anwaypimpalkar/pneumatactors/Content/Pneumatactors_Animation.pptx

Pneumatactors

Pneumatic Solenoids

High

Low

PWM Input

High

Low

Low

1 Atm

Air Pump

1 Atm

Transistor Circuit

High
