anwaypimpalkar/pneumatactors/IEEE Haptics Symposium 2024/Pimpalkar2024_HS2024_WIP.pdf

## Pneumatactor Arrays for High Frequency Vibrotactile Feedback

Anway Pimpalkar¹

, Preshit Ameta²

, Ahan Dalia²

, Jiaxi Zhang²

, and Jeremy D. Brown³

Abstract— Soft and conformable pneumatic tactile interfaces have the potential to complement traditional rigid systems by offering more natural and subtle feedback. This presents the need for economical, scalable miniaturized systems adept in providing high-frequency vibrotactile stimuli. We present the development of a novel silicone-based pneumatic vibrotactor (pneumatactor) array controlled by a sequence of high-frequency air valves engineered to deliver vibrotactile feedback.

I. INTRODUCTION
Traditional vibrotactile haptic displays in common industrial and research applications are built upon largely rigid substrates, and therefore are limited in their abilities to render realistic experiences in a variety of form factors [1]. Pneumatic haptic displays present a promising solution to the limitations of traditional tactile interfaces. Pneumatic bladders, designed to inflate and deflate, can be manufactured in any shape and size, effectively mimicking natural environments. Their adjustable stiffness, which closely resembles human skin, enables the creation of softer, more authentic haptic feedback. Such capabilities hold promise for applications in virtual reality, prosthetics, and beyond. Despite the evident potential, these systems face challenges in bulkiness, cost efficiency, and noise control, which necessitate further development.
High-frequency pneumatic actuation methods have previously been explored. Sonar et al. were pioneers in this field, successfully implementing closed-loop control for solenoidgated pneumatic actuators for frequencies upto 100Hz [2]. Subsequently, van Beek et al. validated the effectiveness of soft Pneumatic Unit Cells [3] with similar frequency characteristics against rigid vibrotactors, utilizing both quantitative and qualitative assessments [4]. However, despite the successful transmission of vibrational data, the resulting devices were notably bulky and costly. In this context, we introduce a novel methodology of producing an arrays of pneumatic vibrotactors (pneumatactors) capable of maintaining frequencies up to 90Hz, while reducing costs by approximately 50% and weight by about 75%.

II. IMPLEMENTATION
The proposed pneumatic tactile haptic device has two intended goals: (1) to rapidly actuate pneumatactors at a range of frequencies controllable through an external trigger,

1Department of Biomedical Engineering, Johns Hopkins University, Baltimore, MD 21218, USA. apimpal1@jhu.edu
2Laboratory for Computational Sensing and Robotics, Johns Hopkins Unjiaiversity, Baltimore, MD 21218, USA. {pameta1, adalia1, jzhan331}@jhu.edu
3Department of Mechanical Engineering, Johns Hopkins University, Baltimore, MD 21218, USA. jdelainebrown@jhu.edu

and (2) to generate independent tactile patterns for the users to feel.
Six cylindrical pneumatactors are fabricated using stereolithography 3D printing with a silicone-based resin. The tactors further undergo a cleaning and curing process for structural hardening. Through an iterative process, the tactors achieve optimized dimensions with an 17mm inner diameter, a 0.4mm diaphragm, a 3mm wall thickness, a 4mm bottom thickness, and a 2mm inlet diameter.
Three sets of pneumatactors are operated by three 3-Way Air Valves. Each valve assembly includes one solenoid connected to a 2.5 l/min 4.5V Air Pump, while the remaining solenoids are interconnected in a parallel arrangement with the first. A unified PWM signal drives three SPDT Relays, which drive the actuation of these valves. At any given instance, airflow within the three valves is directed towards one of the two paired pneumatactors, resulting in a 180◦outof-phase actuation. Since the pump is unidirectionally pumping air out, the valve connection configuration allows the deflation of the other pneumatactor via the third port on the valve, which is open to atmosphere. This deflation is driven by the excess pressure inside the tactor. This setup is depicted in Figure 1 (a) with purple (or labelled ”High”) and green (or labelled ”Low”) arrows highlighting directional flow. The system is controlled by lightweight and stackless multithreads on an Arduino Uno, capable of actuating the three ports with three independent PWM waves.

III. PRELIMINARY ANALYSIS

An inflated pneumatactor is modeled as a spherical cap to estimate the maximum mechanical frequency range possible on the device. The increase in volume V↑ is given by Equation 1:

V↑ =

π × h↑
6

× (3a

2 + h

2
↑
) | (1)

where h↑ is the height of the spherical cap or effective indentation of the skin, and a is the inner radius of the pneumatactor. Using this working volume and the known flow rate, optimization curves are drawn to aid design choices. This method method relies on two key assumptions: 1) the minimum skin indentation sensitivity at higher velocities is approximately 1.5mm for the forearm [5], and 2) the pneumatactor’s maximum deflation time is equal to the inflation time t (constant for given bladder dimensions and material) [6]. Building upon this, Equation 2 determines the pneumatactor’s maximum operational frequency. This corresponds to different skin indent depths at a specified pump flow rate, as depicted in Figure 2.

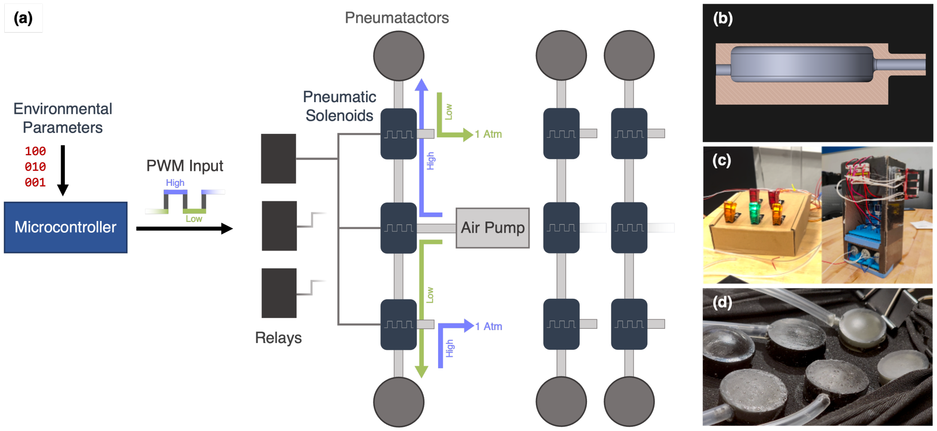
[picture p1: figure]

Fig. 1. (a) Representation of pneumatactor actuation setup, (b) pneumatactor cross-section; (c) constructed actuator prototype; (d) array placement.

fmax =

1
2 ×

V↑
F low Rate

(2)

The device is designed to create skin indentations of 2mm at 90Hz, resulting in an inner radius of 8.5mm based on Equation 2. The indent depth is chosen based on existing literature demonstrating the effectiveness of touch at different levels [5]. These estimated parameters have been validated through the attachment of a piezoelectric disk to the pneumatactor’s diaphragm and high-speed photography.

IV. FUTURE DIRECTIONS

Ongoing efforts are concentrated on quantifying the scalability and resolution of the array. The inverse relationship between frequency and radius in pneumatactors offers exciting prospects for further development. Reducing the size of individual units in an array leads to higher achievable frequencies, although this progression is currently hindered by the actuation speeds of valves and relay circuits. Implementing closed-loop pressure control will allow the pneumatactors to be inflated to a specific pressure and be actuated at specific frequencies centered around it, allowing for both mechanotactile and vibrotactile feedback at the same site. Further reduction in hardware size is also crucial for creating compact, portable systems. Additionally, future perceptual studies with the pneumatactors and comparing the outcomes to those from rigid vibrotactile displays will offer significant insights into the effectiveness of the device.

ACKNOWLEDGMENT

The authors extend their thanks to Shaopeng “Jaspor” Jiang and Dr. Axel Krieger from the IMERSE Lab at Johns Hopkins University for their pivotal role in the manufacturing process of the pneumatactors.

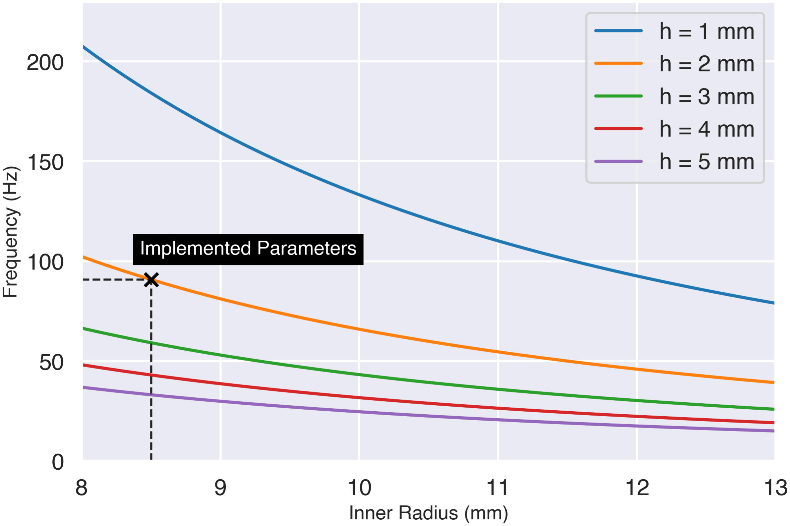
[picture p2: figure]

Fig. 2. Frequency-inner radius relationship and the chosen parameters.

REFERENCES

[1] A. A. Stanley and A. M. Okamura, “Controllable Surface Haptics via Particle Jamming and Pneumatics,” IEEE Transactions on Haptics, vol. 8, no. 1. Institute of Electrical and Electronics Engineers (IEEE), pp. 20–30, Jan. 01, 2015.
[2] H. A. Sonar, A. P. Gerratt, S. P. Lacour, and J. Paik, “Closed-Loop Haptic Feedback Control Using a Self-Sensing Soft Pneumatic Actuator Skin,” Soft Robotics, vol. 7, no. 1. Mary Ann Liebert Inc, pp. 22–29, Feb. 01, 2020.
[3] K. D. Kommuri, F. E. Van Beek, and I. A. Kuling, “Fabrication and Characterization of Pneumatic Unit Cell Actuators,” Actuators, vol. 13, no. 2. MDPI AG, p. 45, Jan. 23, 2024.
[4] F. E. van Beek, Q. P. I. Bisschop, and I. A. Kuling, “Validation of a soft Pneumatic Unit Cell (PUC) in a VR experience: a comparison between vibrotactile and soft pneumatic haptic feedback,” IEEE Transactions on Haptics. Institute of Electrical and Electronics Engineers (IEEE), pp. 1–11, 2024.
[5] P. Burgess, J. Mei, R. Tuckett, K. Horch, C. Ballinger, and D. Poulos, “The neural signal for skin indentation depth. I. Changing indentations,” The Journal of Neuroscience, vol. 3, no. 8. Society for Neuroscience, pp. 1572–1585, Aug. 01, 1983.
[6] H. Bakeri et al., “Silicone Elastomeric-Based Materials of Soft Pneumatic Actuator for Lower-Limb Rehabilitation: Finite Element Modelling and Prototype Experimental Validation,” Applied Sciences, vol. 13, no. 5. MDPI AG, p. 2977, Feb. 25, 2023.
