anwaypimpalkar/pneumatactors/CAD/Tube/Array Idea.png

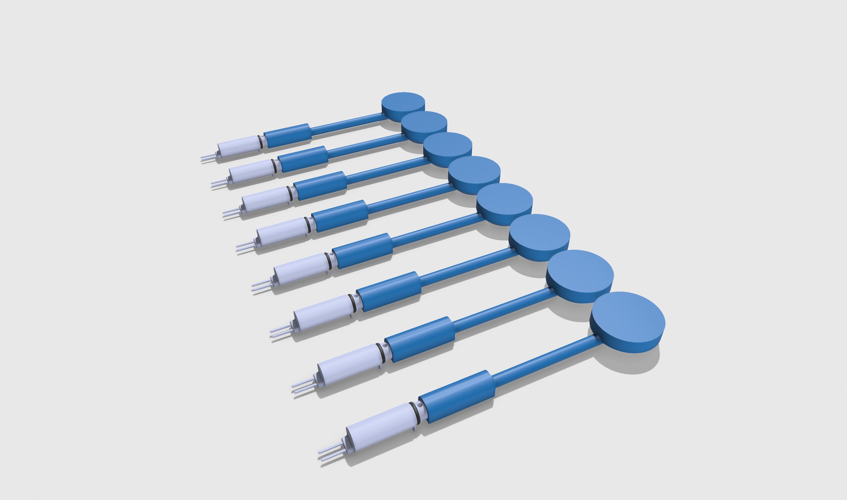
CAD/Tube/Array Idea.png
