anwaypimpalkar/pneumatactors/PCBs/Pneumatactors_1Xiao_CompactControl_Battery/Pneumatactors_1Xiao_CompactControl_Battery_Back.png

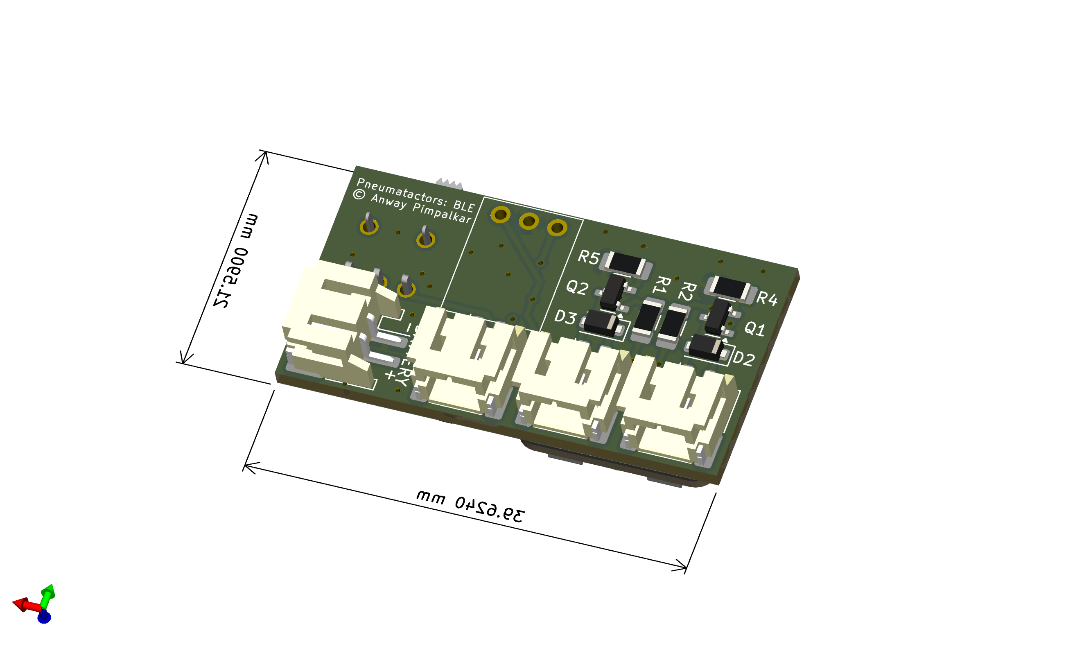
PCBs/Pneumatactors_1Xiao_CompactControl_Battery/Pneumatactors_1Xiao_CompactControl_Battery_Back.png
