anwaypimpalkar/pneumatactors/PCBs/Pneumatactors_1Xiao_CompactControl_Battery/Pneumatactors_1Xiao_CompactControl_Battery_Front.png

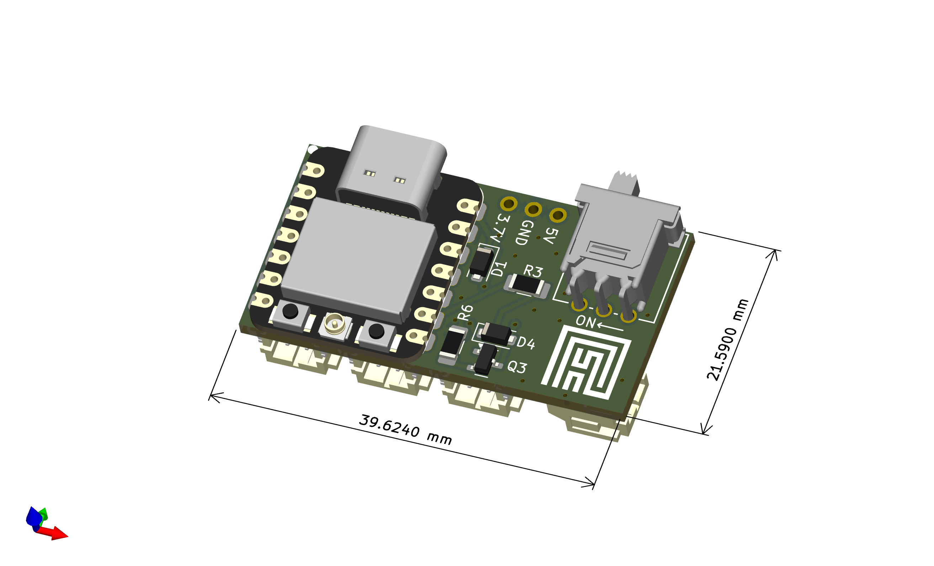
PCBs/Pneumatactors_1Xiao_CompactControl_Battery/Pneumatactors_1Xiao_CompactControl_Battery_Front.png
