anwaypimpalkar/pneumatactors/Hannah's Files/pneucuff_files/pneucuff_33mm_valveandportintegration_latticeonly.SLDASM

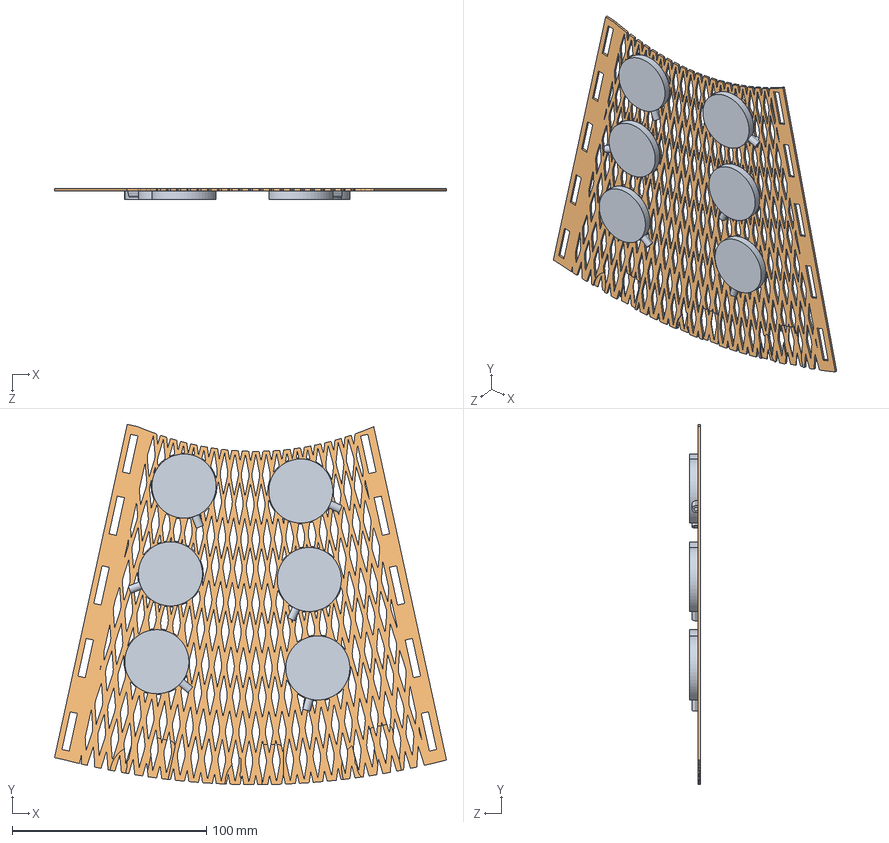
[picture p7: CAD file, 2025-06-20]
Hannah's Files/pneucuff_files/pneucuff_33mm_valveandportintegration_latticeonly.SLDASM
201.7 x 185.3 x 5.44 mm
flex_cuff_v4_square
pneu_33mm_multiconfigport x 6
