anwaypimpalkar/pneumatactors/3D Printing/Anway (Don't Delete Please)- I WILL DO IT/Pneumatactors_Wrist_Pad.3mf

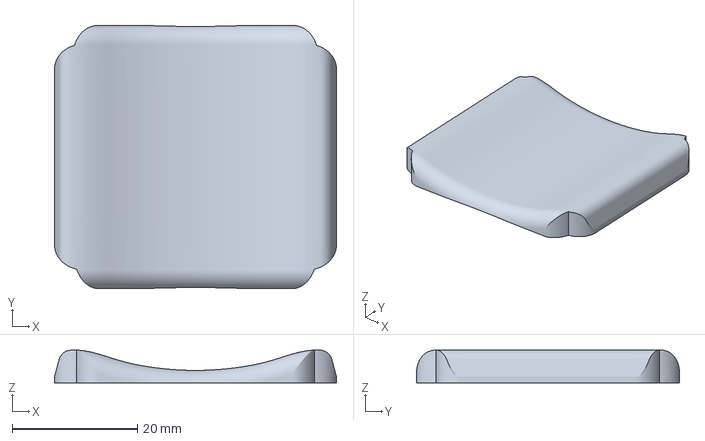
[picture p8: CAD file, 2025-06-20]
3D Printing/Anway (Don't Delete Please)- I WILL DO IT/Pneumatactors_Wrist_Pad.3mf
45.0 x 42.0 x 5.25 mm
