anwaypimpalkar/pneumatactors/CAD/Finger/Final Set/FingerCup_SingleChambers_v4_10Set_ForPrinting/FingerCup_SingleChambers_v4_10Set_ForPrinting_24mm.step

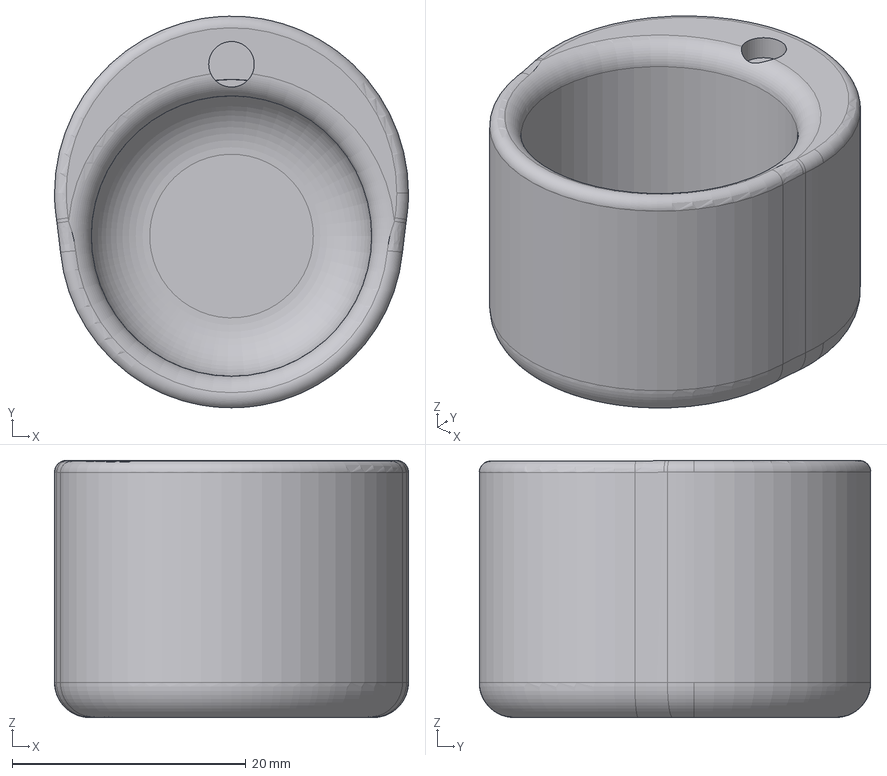
[picture p9: CAD file, 2025-06-20]
CAD/Finger/Final Set/FingerCup_SingleChambers_v4_10Set_ForPrinting/FingerCup_SingleChambers_v4_10Set_ForPrinting_24mm.step
30.3 x 33.5 x 22.0 mm
