anwaypimpalkar/pneumatactors/CAD/Finger/Finger_SingleChamber_v3_15.6.step

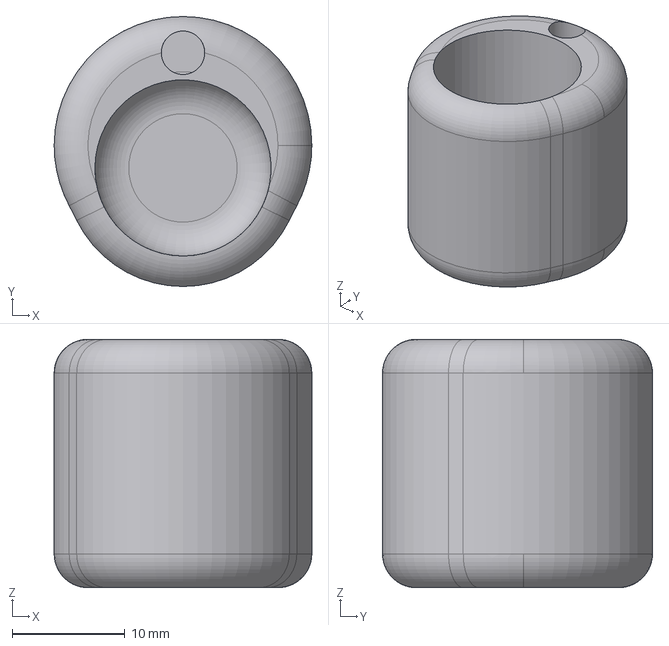
[picture p10: CAD file, 2025-06-20]
CAD/Finger/Finger_SingleChamber_v3_15.6.step
22.8 x 23.9 x 22.0 mm
