anwaypimpalkar/pneumatactors/CAD/HAND/Pneumatactor_HAND_v3_15.6.stl

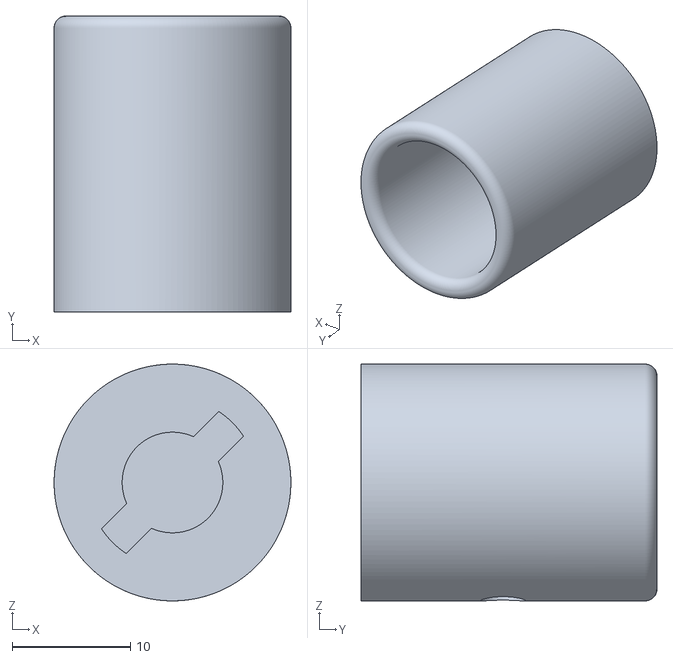
[picture p11: CAD file, 2025-03-19]
CAD/HAND/Pneumatactor_HAND_v3_15.6.stl
20.0 x 25.0 x 20.0
