anwaypimpalkar/pneumatactors/CAD/PUC_WIP_7_23mm.STL

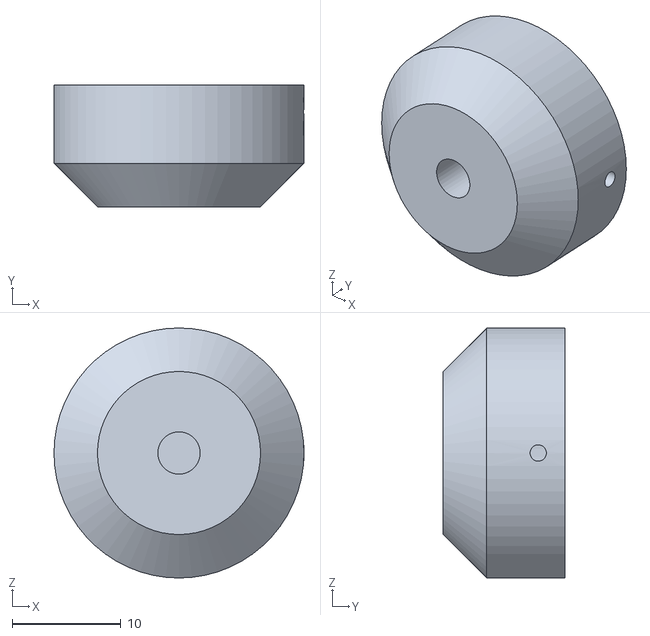
[picture p12: CAD file, 2025-03-06]
CAD/PUC_WIP_7_23mm.STL
23.0 x 11.2 x 23.0
