anwaypimpalkar/pneumatactors/CAD/Test Box/Pneumtactors_TestBed_Box.obj

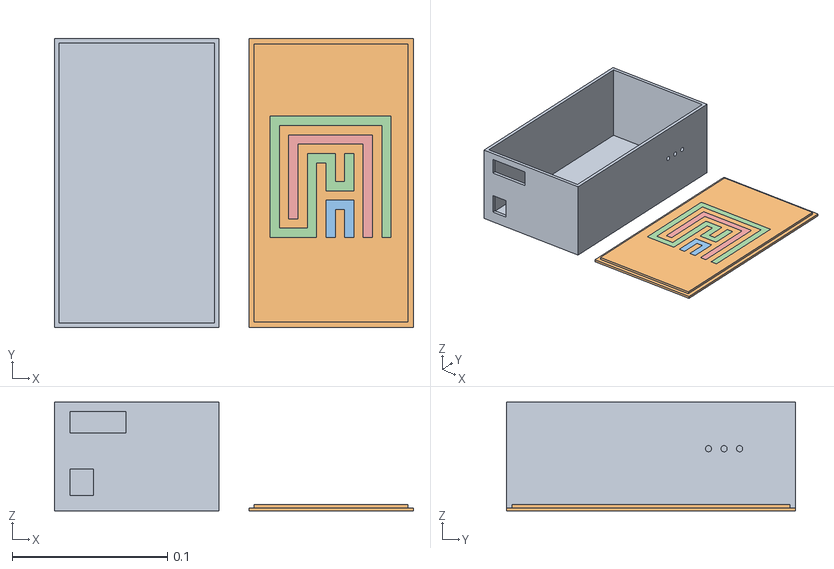
[picture p13: CAD file, 2025-06-20]
CAD/Test Box/Pneumtactors_TestBed_Box.obj
0.231 x 0.186 x 0.07
