anwaypimpalkar/pneumatactors/CAD/Tube/Pneumatactor_Tube_Extension.step

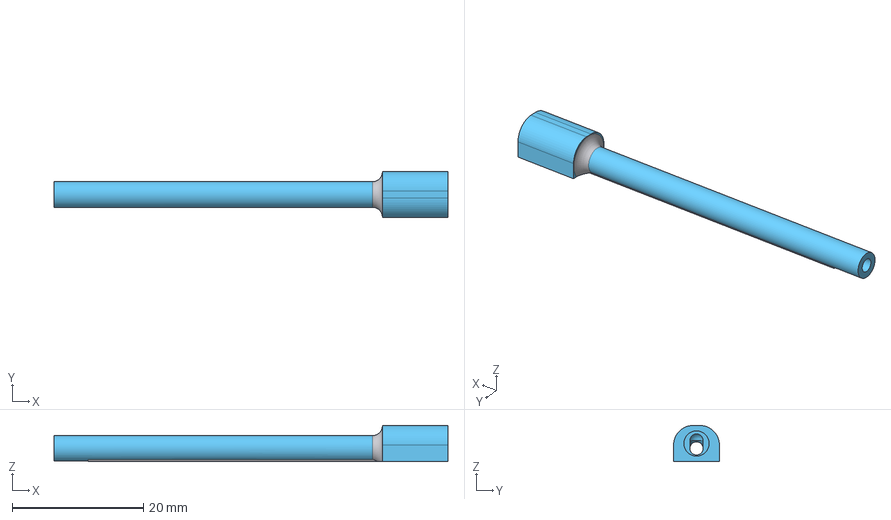
[picture p14: CAD file, 2025-06-20]
CAD/Tube/Pneumatactor_Tube_Extension.step
60.0 x 7.00 x 5.50 mm
PUC_WIP_FDM.STEP x 2
Imported
