anwaypimpalkar/pneumatactors/CAD/Valve Holder/Solenoid Holder with tubing.SLDPRT

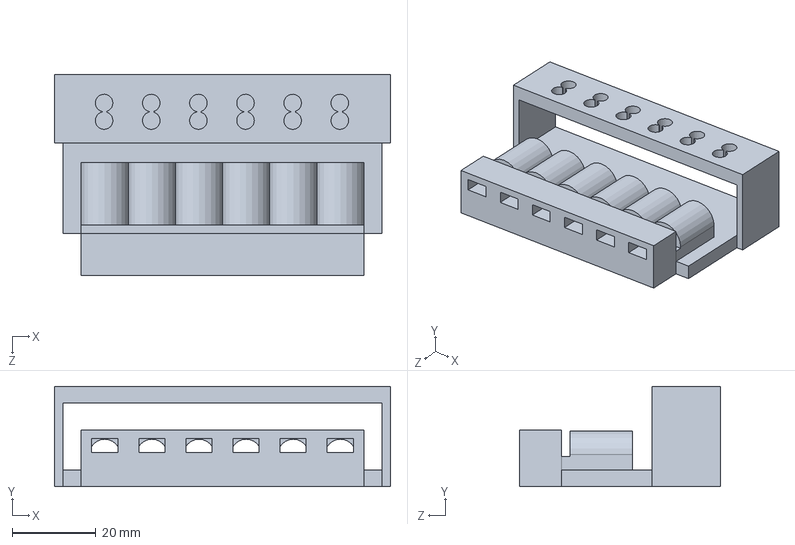
[picture p15: CAD file, 2025-03-29]
CAD/Valve Holder/Solenoid Holder with tubing.SLDPRT
80.3 x 24.0 x 48.0 mm
