anwaypimpalkar/pneumatactors/CAD/Valves/Lee-LHQ_Series-3-Port_Plug-In-CAD_Model_A2.step

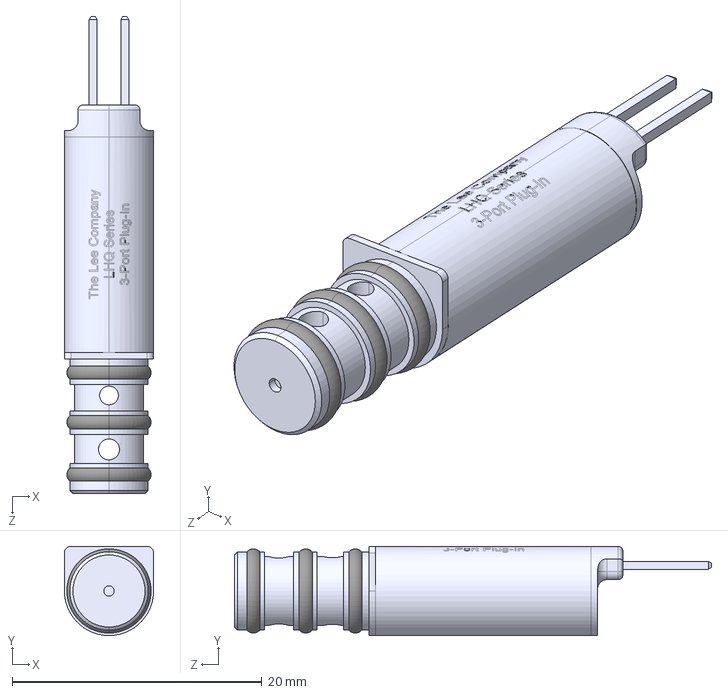
[picture p16: CAD file, 2025-06-20]
CAD/Valves/Lee-LHQ_Series-3-Port_Plug-In-CAD_Model_A2.step
7.14 x 7.14 x 38.2 mm
