anwaypimpalkar/pneumatactors/CAD/VR Task/upper_pointer_finger_v2.STEP

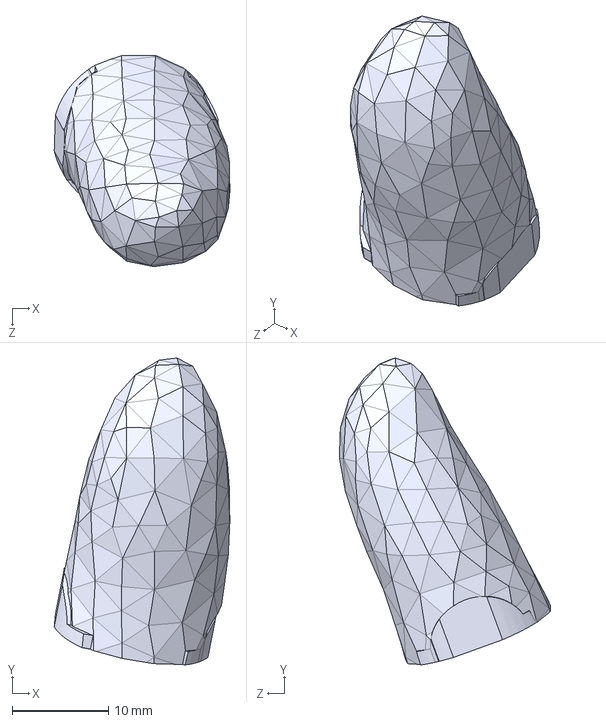
[picture p17: CAD file, 2025-06-20]
CAD/VR Task/upper_pointer_finger_v2.STEP
18.3 x 31.9 x 22.0 mm
