anwaypimpalkar/pneumatactors/CAD/Wrist/Pneumatactors_WristSqueeze.stl

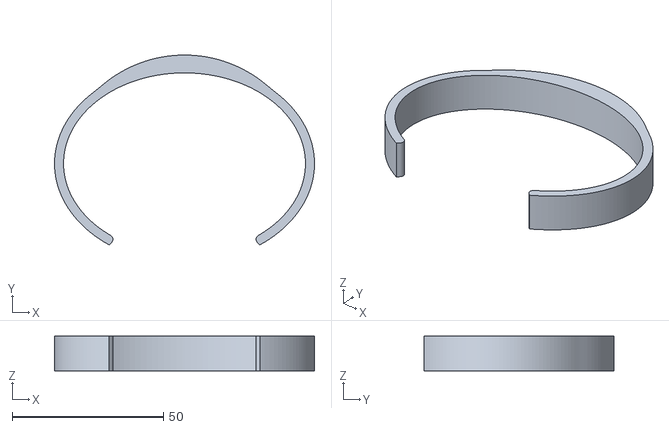
[picture p18: CAD file, 2025-06-20]
CAD/Wrist/Pneumatactors_WristSqueeze.stl
86.0 x 62.8 x 11.5
