anwaypimpalkar/pneumatactors/Hannah's Files/Hannah's Files Cleaned/handdevice_tubeprint_v2_female.STEP

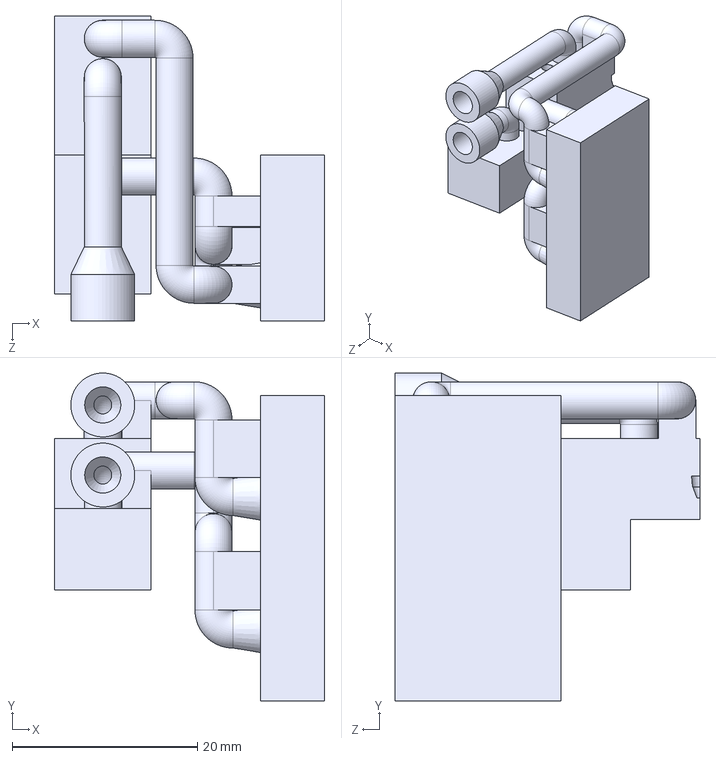
[picture p19: CAD file, 2025-06-20]
Hannah's Files/Hannah's Files Cleaned/handdevice_tubeprint_v2_female.STEP
29.2 x 35.4 x 32.9 mm
