anwaypimpalkar/pneumatactors/Hannah's Files/pneucuff_files/handdevice_tubeprint_v1.STEP

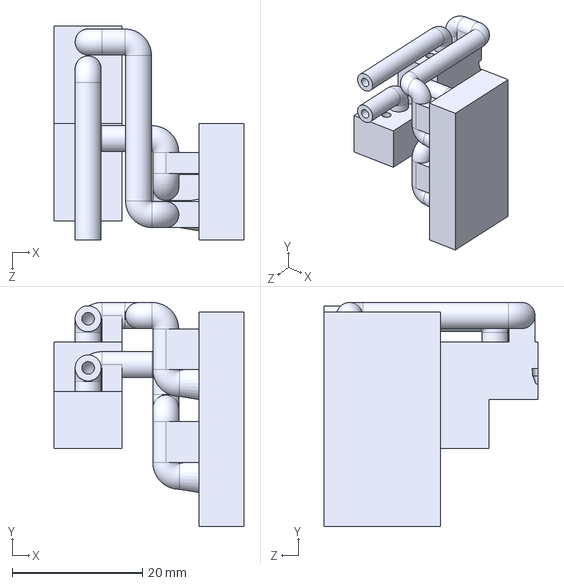
[picture p20: CAD file, 2025-06-20]
Hannah's Files/pneucuff_files/handdevice_tubeprint_v1.STEP
29.2 x 34.5 x 32.9 mm
