anwaypimpalkar/pneumatactors/PCBs/Pneumatactors_1Xiao_3Pumps_8Valves/Pneumatactors_1Xiao_3Pumps_8Valves.step

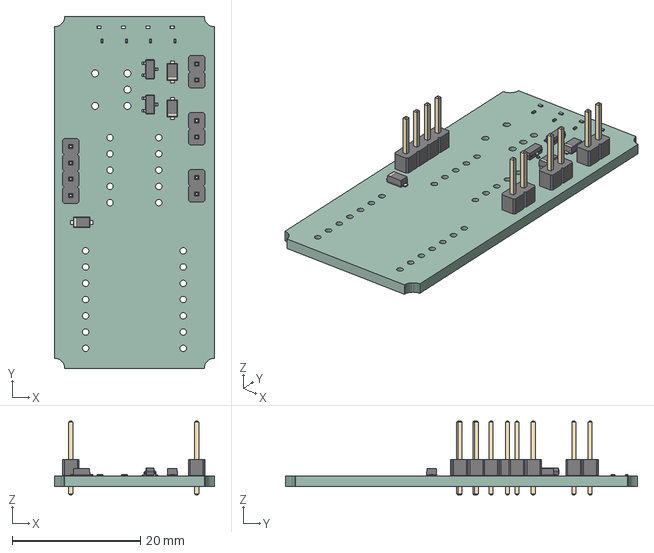
[picture p24: CAD file, 2025-03-29]
PCBs/Pneumatactors_1Xiao_3Pumps_8Valves/Pneumatactors_1Xiao_3Pumps_8Valves.step
25.0 x 55.0 x 11.5 mm
Pneumatactors_1Xiao_CompactControl PCB
