anwaypimpalkar/pneumatactors/PCBs/Pneumatactors_1Xiao_PiezoPumps_2Valves/Pneumatactors_ Pneumatactors_1Xiao_PiezoPumps_2Valves.step

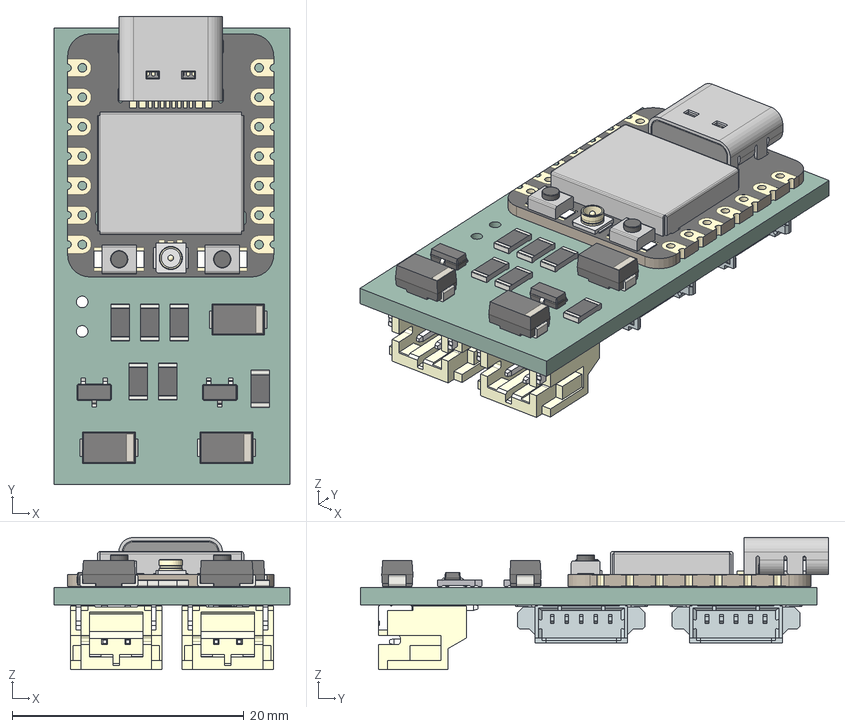
[picture p25: CAD file, 2025-06-20]
PCBs/Pneumatactors_1Xiao_PiezoPumps_2Valves/Pneumatactors_ Pneumatactors_1Xiao_PiezoPumps_2Valves.step
20.3 x 40.4 x 11.4 mm
R_1206_3216Metric x 6
D_SMA x 3
SOT-23 x 2
BOSS-EXTRUDE14_8_
BOSS-EXTRUDE7_4_
BOSS-EXTRUDE7_3_
BOSS-EXTRUDE14_4_
BOSS-EXTRUDE14_2_
BOSS-EXTRUDE14_11_
BOSS-EXTRUDE7_7_
BOSS-EXTRUDE14_9_
BOSS-EXTRUDE14_3_
BOSS-EXTRUDE14_7_
MIRROR2
BOSS-EXTRUDE14_5_
BOSS-EXTRUDE14_12_
BOSS-EXTRUDE7_8_
BOSS-EXTRUDE7_1_
BOSS-EXTRUDE14_10_
BOSS-EXTRUDE7_9_
BOSS-EXTRUDE14_6_
BOSS-EXTRUDE14_1_
BOSS-EXTRUDE7_6_
BOSS-EXTRUDE7_2_
CUT-EXTRUDE5
BOSS-EXTRUDE7_5_
U.FL Connector v1
Button (1) x 2
Shield
PinHeader_1x02_P2.54mm_Vertical
S2B-PH-SM4-TB x 2
Pneumatactors_1Xiao_PiezoPumps_2Valves_Wrong_PCB
