anwaypimpalkar/pneumatactors/PCBs/Pneumatactors_EmbeddedPressureSensing/2450AT18B100E/2450AT18B100E.step

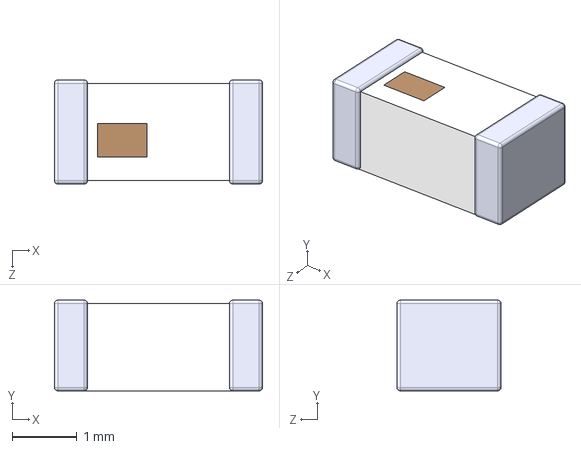
[picture p26: CAD file, 2025-06-20]
PCBs/Pneumatactors_EmbeddedPressureSensing/2450AT18B100E/2450AT18B100E.step
3.20 x 1.40 x 1.60 mm
