anwaypimpalkar/pneumatactors/PCBs/Pneumatactors_EmbeddedPressureSensing/BHSD_1225_SM/BHSD-1225-SM.step

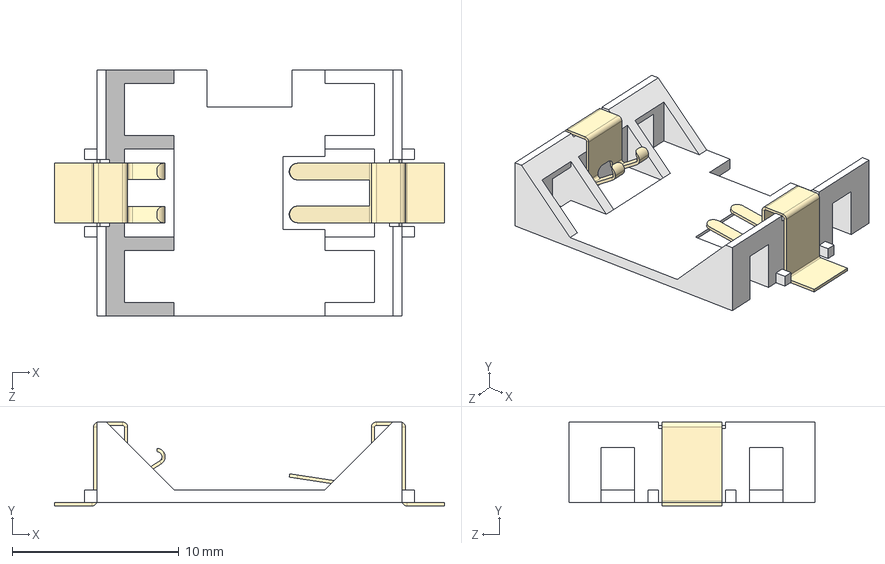
[picture p27: CAD file, 2025-06-20]
PCBs/Pneumatactors_EmbeddedPressureSensing/BHSD_1225_SM/BHSD-1225-SM.step
23.4 x 5.03 x 14.7 mm
