anwaypimpalkar/pneumatactors/PCBs/Pneumatactors_EmbeddedPressureSensing/ESP32_S3/ESP32-S3.step

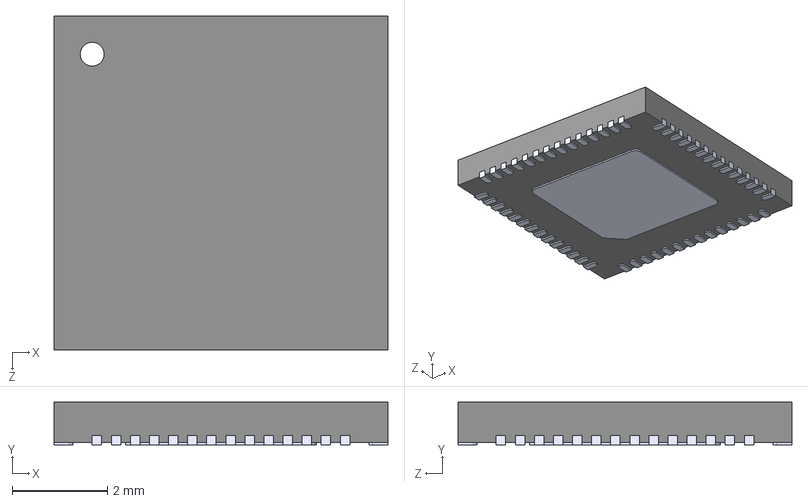
[picture p28: CAD file, 2025-06-20]
PCBs/Pneumatactors_EmbeddedPressureSensing/ESP32_S3/ESP32-S3.step
7.00 x 0.9 x 7.00 mm
