anwaypimpalkar/pneumatactors/CAD/Finger/Final Set/FingerCup_SingleChambers_v4_10Set_ForPrinting/FingerCup_SingleChambers_v4_10Set_ForPrinting_17mm.step

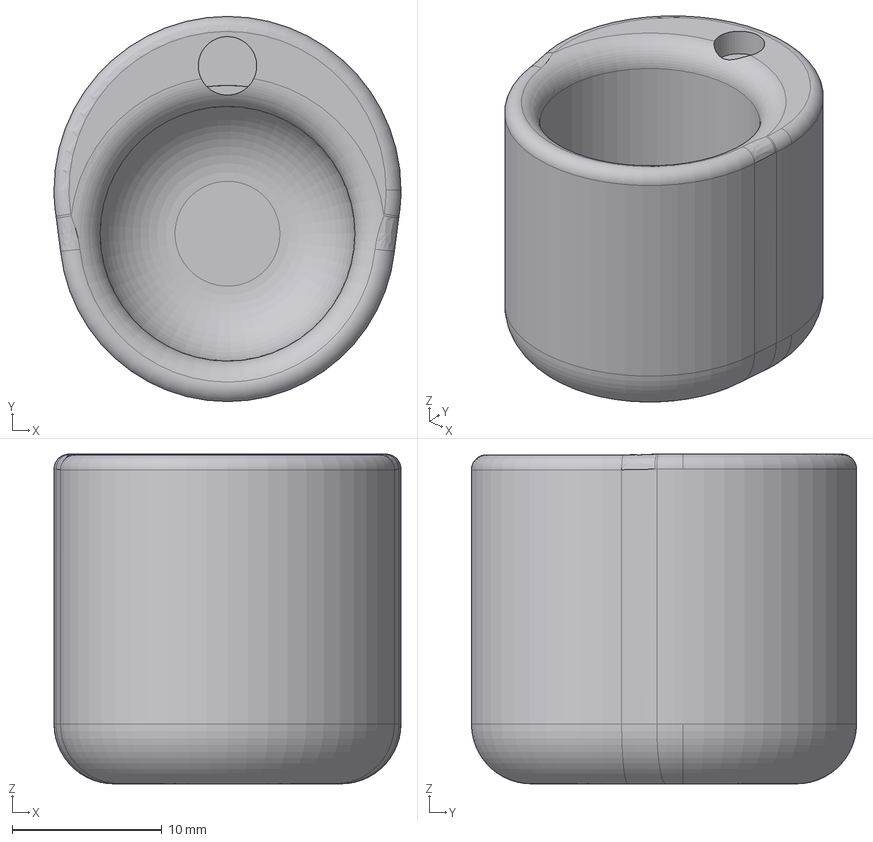
[picture p29: CAD file, 2025-06-20]
CAD/Finger/Final Set/FingerCup_SingleChambers_v4_10Set_ForPrinting/FingerCup_SingleChambers_v4_10Set_ForPrinting_17mm.step
23.2 x 25.7 x 22.0 mm
