anwaypimpalkar/pneumatactors/CAD/Test Box/Pneumatactors_Testbed_STEP.step

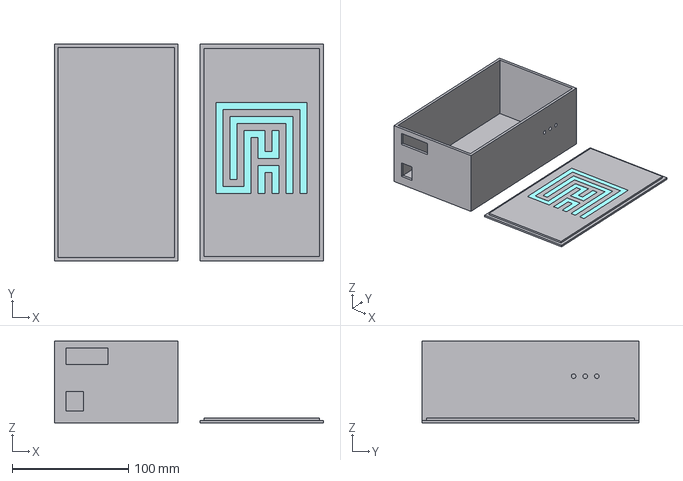
[picture p30: CAD file, 2025-06-20]
CAD/Test Box/Pneumatactors_Testbed_STEP.step
231.0 x 186.0 x 70.0 mm
