anwaypimpalkar/pneumatactors/Hannah's Files/pneucuff_files/pneu_23mm_femalesideconnect.STEP

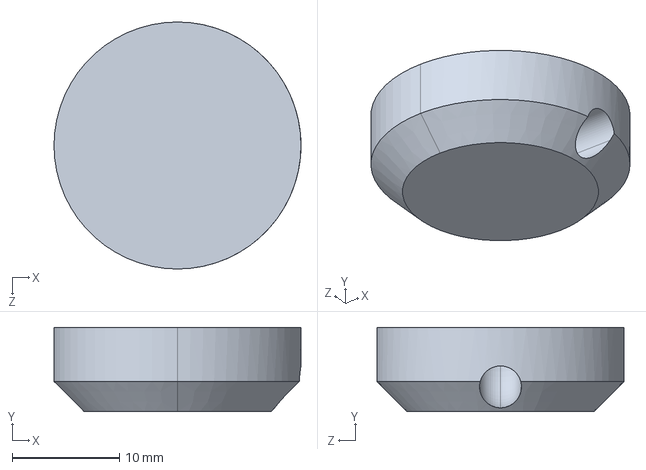
[picture p31: CAD file, 2025-06-20]
Hannah's Files/pneucuff_files/pneu_23mm_femalesideconnect.STEP
23.0 x 7.84 x 23.0 mm
