anwaypimpalkar/pneumatactors/CAD/Finger/Final Set/FingerCup_SingleChambers_v4_10Set_ForPrinting/FingerCup_SingleChambers_v4_10Set_ForPrinting_22mm.step

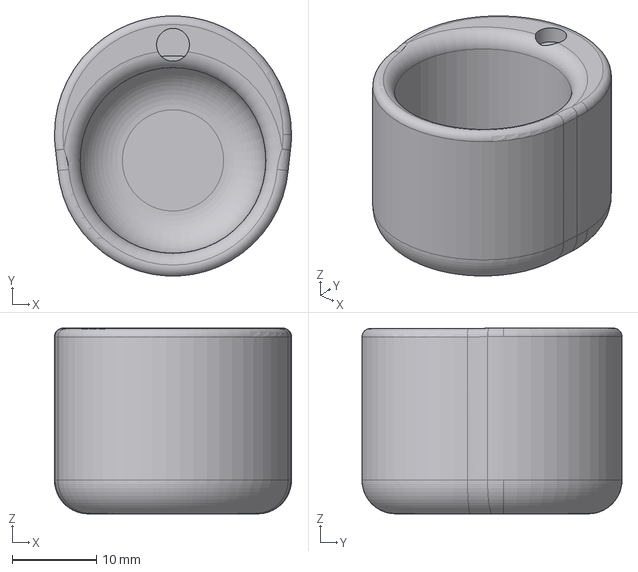
[picture p32: CAD file, 2025-06-20]
CAD/Finger/Final Set/FingerCup_SingleChambers_v4_10Set_ForPrinting/FingerCup_SingleChambers_v4_10Set_ForPrinting_22mm.step
28.1 x 30.8 x 22.0 mm
