anwaypimpalkar/pneumatactors/Hannah's Files/Hannah's Files Cleaned/flex_cuff_v4_square.SLDPRT

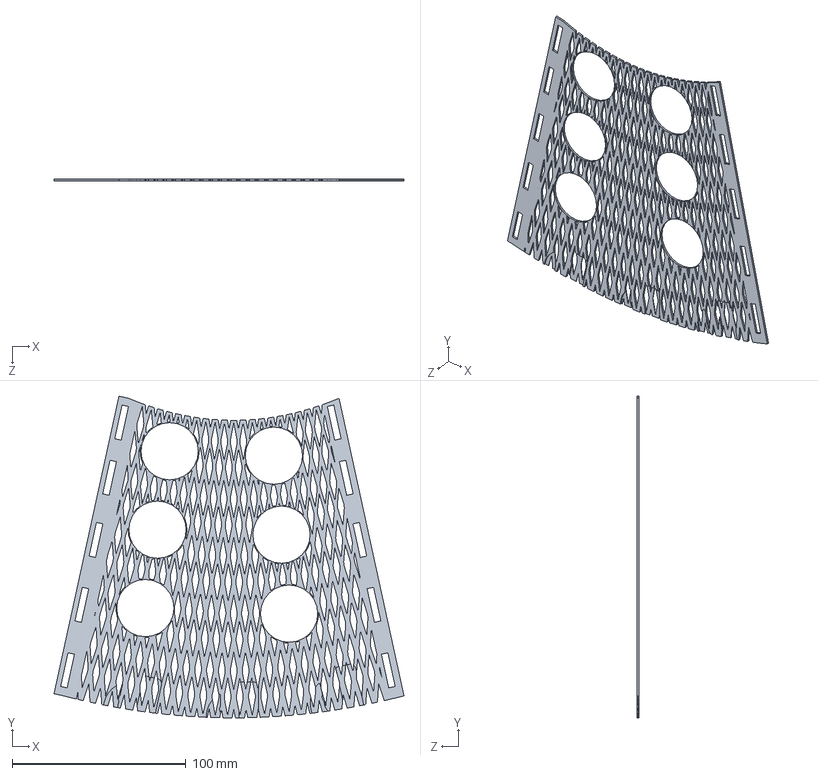
[picture p33: CAD file, 2025-06-20]
Hannah's Files/Hannah's Files Cleaned/flex_cuff_v4_square.SLDPRT
201.7 x 185.3 x 1.27 mm
