anwaypimpalkar/pneumatactors/CAD/Finger/Final Set/FingerCup_SingleChambers_v4_10Set_ForPrinting/FingerCup_SingleChambers_v4_10Set_ForPrinting_18mm.step

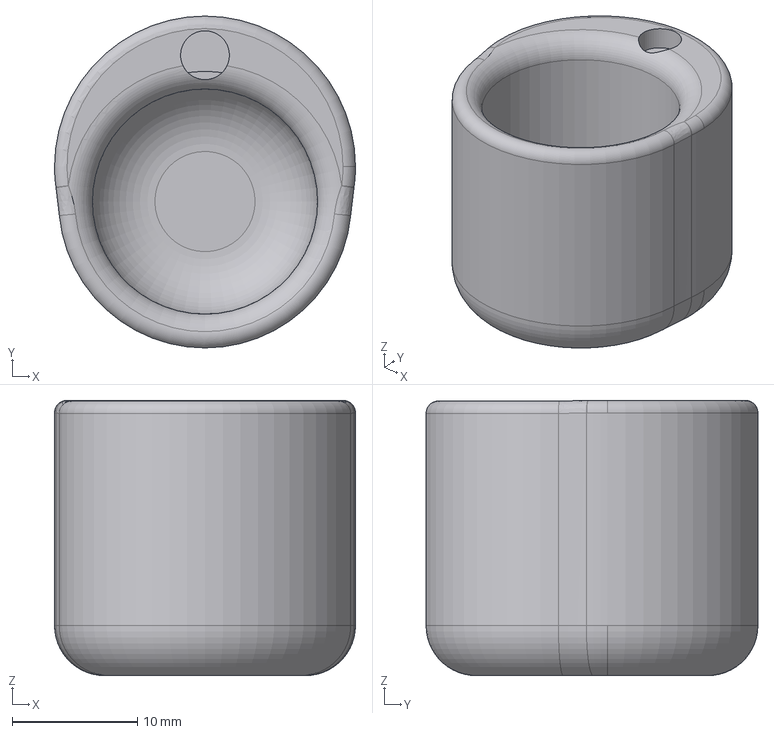
[picture p34: CAD file, 2025-06-20]
CAD/Finger/Final Set/FingerCup_SingleChambers_v4_10Set_ForPrinting/FingerCup_SingleChambers_v4_10Set_ForPrinting_18mm.step
24.1 x 26.5 x 22.0 mm
