anwaypimpalkar/pneumatactors/CAD/Finger/Finger_SingleChamber_v2_15.6.stl

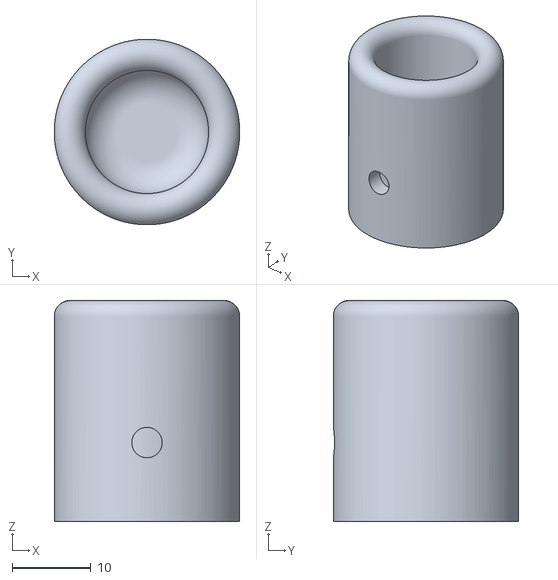
[picture p35: CAD file, 2025-03-06]
CAD/Finger/Finger_SingleChamber_v2_15.6.stl
23.5 x 23.5 x 28.0
