anwaypimpalkar/pneumatactors/Hannah's Files/Hannah's Files Cleaned/pneucuff_23mm_femaletopconnect_wstraps.SLDPRT

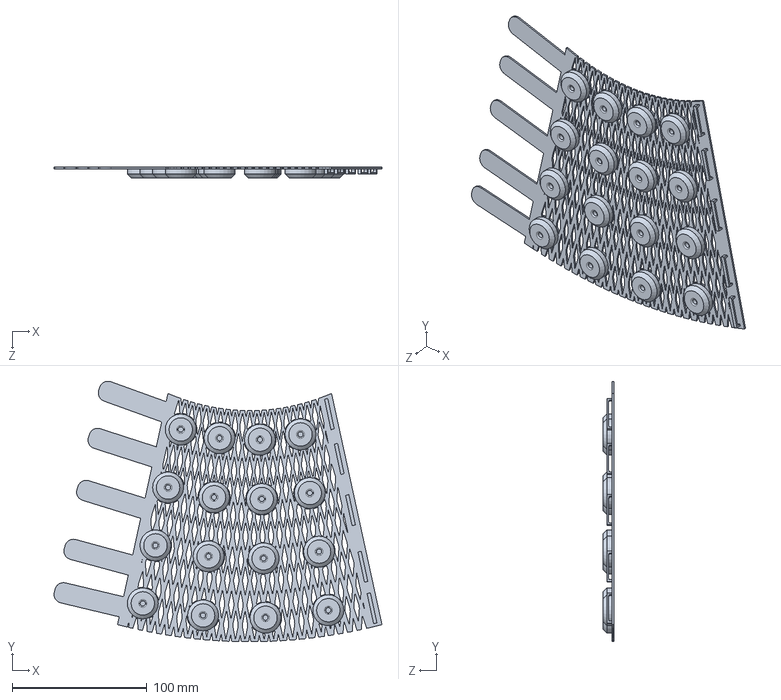
[picture p36: CAD file, 2025-06-20]
Hannah's Files/Hannah's Files Cleaned/pneucuff_23mm_femaletopconnect_wstraps.SLDPRT
243.3 x 193.2 x 7.84 mm
