anwaypimpalkar/pneumatactors/CAD/Finger/Final Set/FingerCup_SingleChambers_v4_10Set_ForPrinting/FingerCup_SingleChambers_v4_10Set_ForPrinting_21mm.step

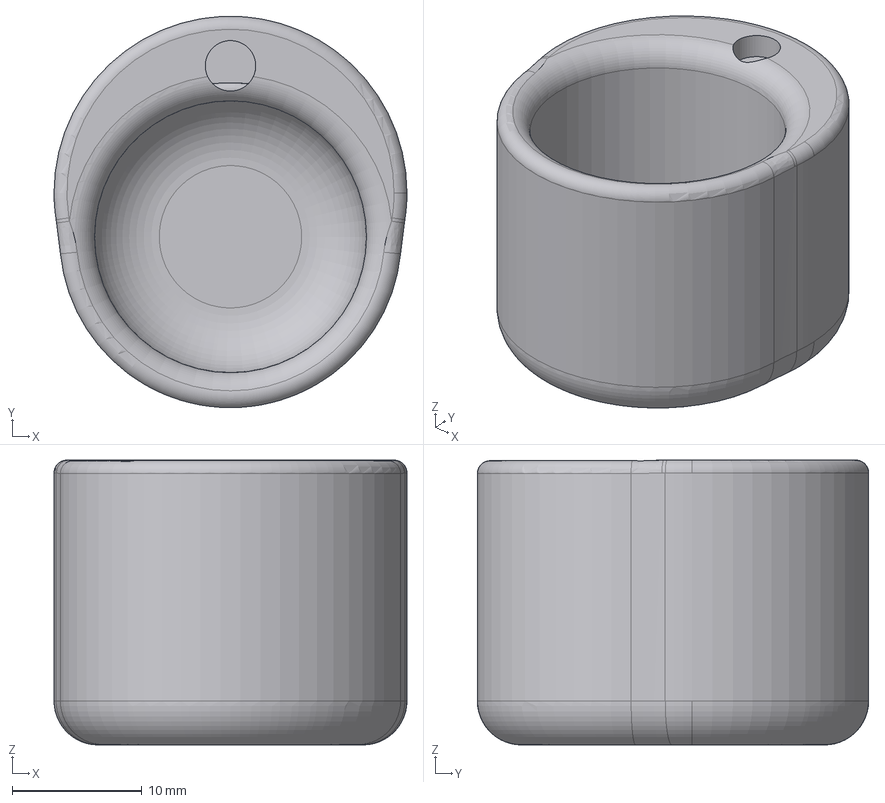
[picture p37: CAD file, 2025-06-20]
CAD/Finger/Final Set/FingerCup_SingleChambers_v4_10Set_ForPrinting/FingerCup_SingleChambers_v4_10Set_ForPrinting_21mm.step
27.3 x 30.2 x 22.0 mm
