anwaypimpalkar/pneumatactors/Hannah's Files/Hannah's Files Cleaned/pneucuff_33mm_withfemaletubing.SLDPRT

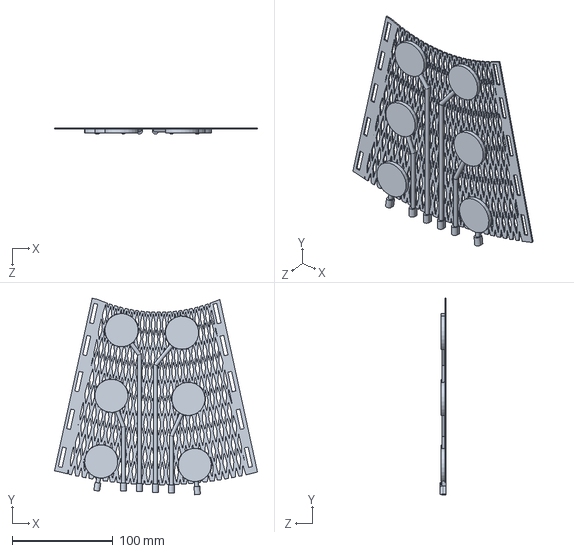
[picture p38: CAD file, 2025-06-20]
Hannah's Files/Hannah's Files Cleaned/pneucuff_33mm_withfemaletubing.SLDPRT
201.7 x 195.3 x 6.12 mm
