anwaypimpalkar/pneumatactors/Hannah's Files/pneucuff_files/Y coupler.SLDPRT

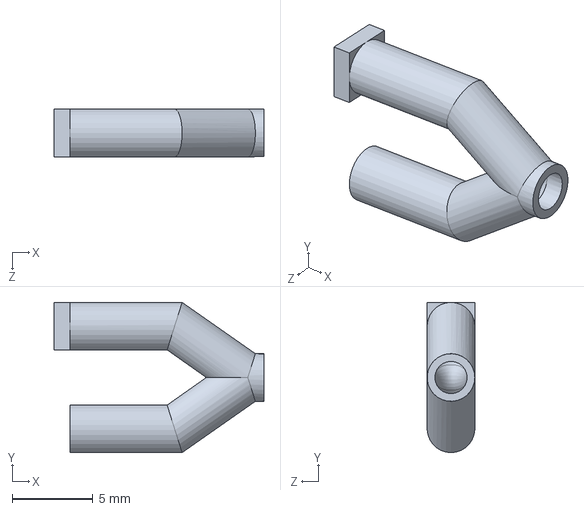
[picture p39: CAD file, 2025-06-20]
Hannah's Files/pneucuff_files/Y coupler.SLDPRT
13.0 x 9.30 x 2.95 mm
