anwaypimpalkar/pneumatactors/Hannah's Files/Hannah's Files Cleaned/pneucuff_23mm_holes_nostraps.SLDPRT

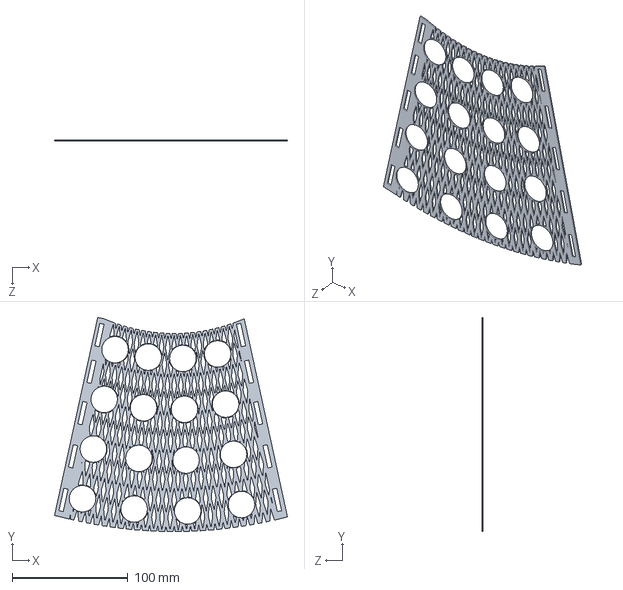
[picture p41: CAD file, 2025-06-20]
Hannah's Files/Hannah's Files Cleaned/pneucuff_23mm_holes_nostraps.SLDPRT
201.7 x 185.3 x 1.27 mm
