anwaypimpalkar/pneumatactors/Hannah's Files/Hannah's Files Cleaned/pneu_33mm_multiconfigport.SLDPRT

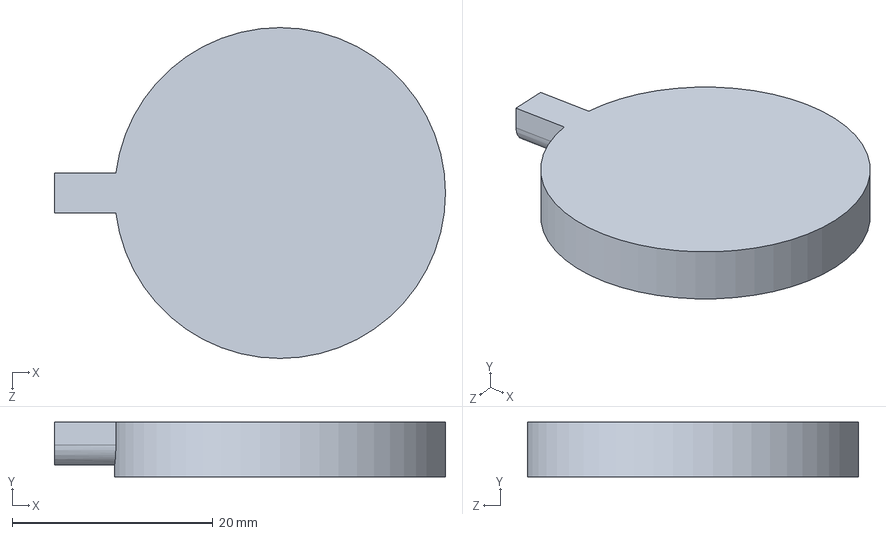
[picture p43: CAD file, 2025-06-20]
Hannah's Files/Hannah's Files Cleaned/pneu_33mm_multiconfigport.SLDPRT
39.0 x 5.44 x 33.0 mm
