anwaypimpalkar/pneumatactors/Hannah's Files/Hannah's Files Cleaned/pneutubing_femaleadapter.SLDPRT

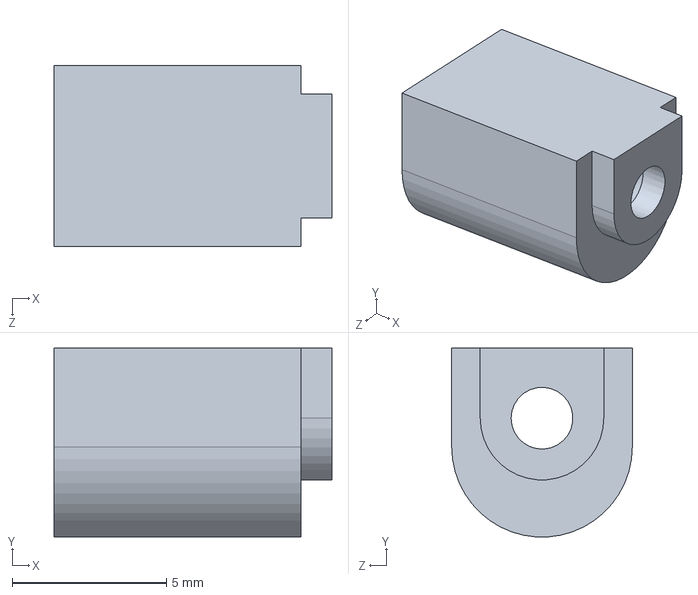
[picture p45: CAD file, 2025-06-20]
Hannah's Files/Hannah's Files Cleaned/pneutubing_femaleadapter.SLDPRT
9.00 x 6.11 x 5.85 mm
