anwaypimpalkar/pneumatactors/Hannah's Files/Hannah's Files Cleaned/ported_valve.SLDPRT

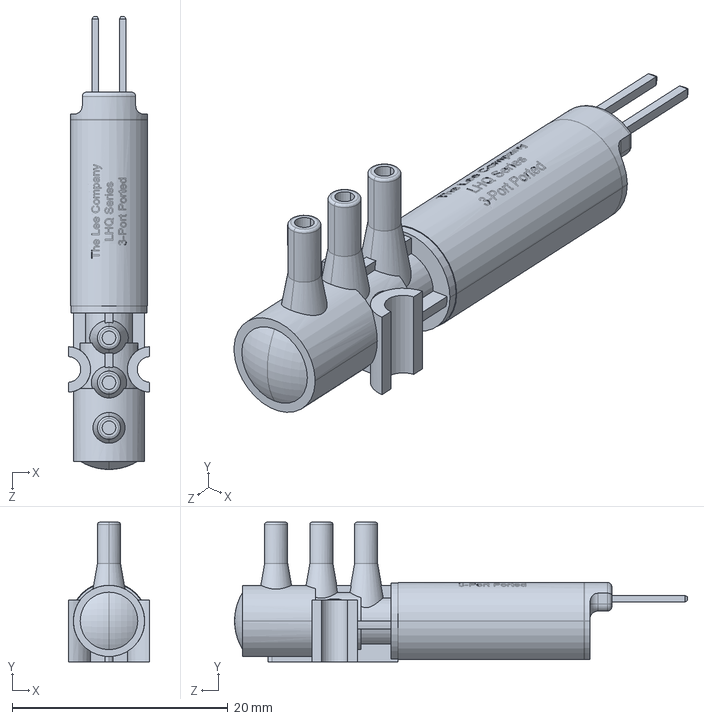
[picture p48: CAD file, 2025-06-20]
Hannah's Files/Hannah's Files Cleaned/ported_valve.SLDPRT
7.47 x 12.9 x 42.0 mm
