anwaypimpalkar/pneumatactors/Hannah's Files/Hannah's Files Cleaned/pneucuff_23mm_femalesideconnect_nostraps.SLDASM

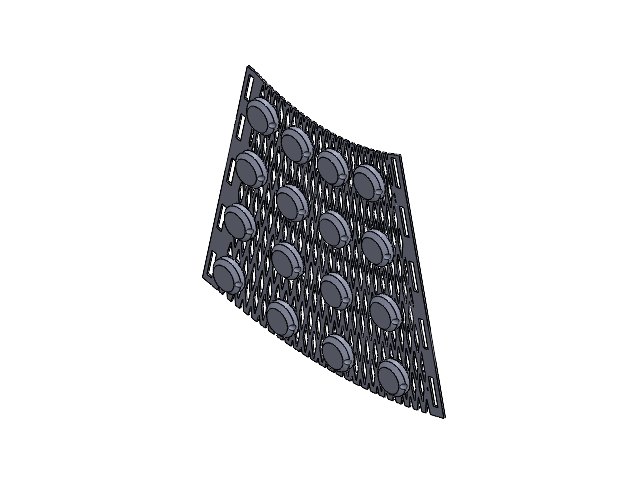
[picture p49: CAD file, 2025-06-20]
Hannah's Files/Hannah's Files Cleaned/pneucuff_23mm_femalesideconnect_nostraps.SLDASM
pneucuff_23mm_holes_nostraps
pneu_23mm_femalesideconnect x 16
