anwaypimpalkar/pneumatactors/Hannah's Files/Hannah's Files Cleaned/dualvalvehousingv2_valveandportasm.SLDASM

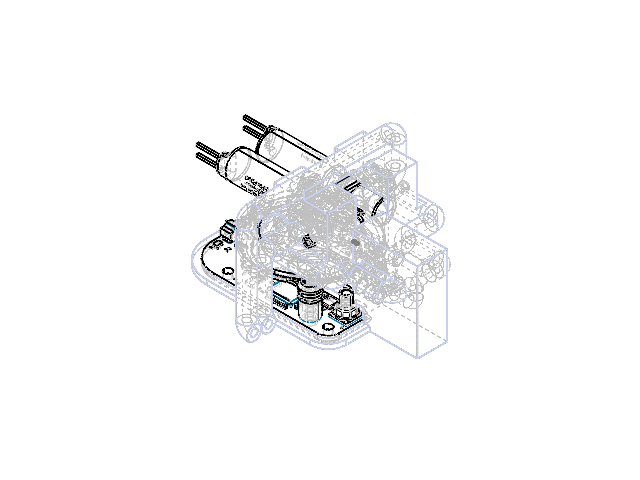
[picture p50: CAD file, 2025-06-20]
Hannah's Files/Hannah's Files Cleaned/dualvalvehousingv2_valveandportasm.SLDASM
pump_pcb
dualvalvehousingv2_ported_pneucuffintegration
ported_valve x 2
