anwaypimpalkar/pneumatactors/Hannah's Files/pneucuff_files/pump_pcb.SLDASM

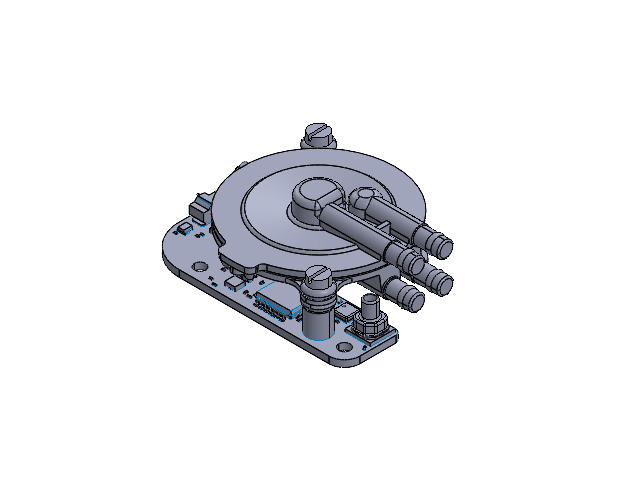
[picture p51: CAD file, 2025-06-20]
Hannah's Files/pneucuff_files/pump_pcb.SLDASM
59017-900-0453.step
ttp-ventus-disc-pump-bl-xp-lt-series-model.step
59017-900-0450 sub part flexi tail.step
59017-900-0450-sub-part-rigidiser.step
EK-02-0035.step x 4
EK-02-0034.step x 2
