anwaypimpalkar/pneumatactors/(list of files, cad)

Other CAD files:
CAD/Tube/Pneumatactor_Tube.stl
CAD/Test Box/Pneumatactors Test Box.stl
Hannah's Files/pneucuff_files/pneucuff_33mm_withfemaletubing_duplicate.SLDPRT
Hannah's Files/Hannah's Files Cleaned/pneucuff_33mm_withfemaletubing_duplicate.SLDPRT
CAD/Finger/Finger_SingleChamber_v1.stl
CAD/Finger/Finger_SingleChamber_v2_15.2.stl
CAD/HAND/Pneumatactor_HAND_v1.stl
CAD/HAND/Pneumatactor_HAND_v2.stl
CAD/Pump/dd2102200_asm.stp
CAD/Valve Holder/Solenoid Holder with tubing.STL
Hannah's Files/Hannah's Files Cleaned/pneu_23mm_femalesideconnect.SLDPRT
Hannah's Files/Hannah's Files Cleaned/portless_valve.SLDPRT
Hannah's Files/pneucuff_files/pneu_23mm_femalesideconnect.SLDPRT
Hannah's Files/pneucuff_files/portless_valve.SLDPRT
PCBs/Components/PicoBlade 2 Pin Vertical/533984002.stp
PCBs/Components/PicoBlade 5 Pin/0532610571.stp
PCBs/Components/Picoblade 8 Pin/532610871.stp
PCBs/Pneumatactors_EmbeddedPressureSensing/MS580301BA01_00/MS580301BA01-00.STEP
