anwaypimpalkar/pneumatactors/Virtual Task/p02/p02_calibration_raw.csv

Timestamp (s) | Raw EMG | Filtered EMG
0.0 | -0.776519775390625 | 0.5552455455293608
0.0004980564117431641 | -0.76080322265625 | 0.5569061146534777
0.0009958744049072266 | -0.76080322265625 | 0.5585615519224114
0.0014908313751220703 | -0.76080322265625 | 0.560211904897597
0.001987934112548828 | -0.76080322265625 | 0.5618572204097012
0.002482175827026367 | -0.31646728515625 | 0.5620766001278235
0.002978801727294922 | -0.31646728515625 | 0.562295890858082
0.0034744739532470703 | -0.31646728515625 | 0.5625150927092957
0.0044672489166259766 | -0.31646728515625 | 0.5627342057900614
0.004961967468261719 | 0.038909912109375 | 0.5626949513205334
0.0054607391357421875 | 0.038909912109375 | 0.5626556941059561
0.0059566497802734375 | 0.038909912109375 | 0.5626164341457518
0.0069468021392822266 | 0.400848388671875 | 0.563116870405715
0.009922027587890625 | 0.400848388671875 | 0.5636168229930563
0.010417938232421875 | 0.714874267578125 | 0.5652931399407334
0.010915040969848633 | 0.714874267578125 | 0.5669642894489932
0.01141047477722168 | 0.714874267578125 | 0.5686303192337376
0.012403726577758789 | -0.079193115234375 | 0.5686332313731453
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
