anwaypimpalkar/pneumatactors/Virtual Task/p01/p01_calibration_raw.csv

Timestamp (s) | Raw EMG | Filtered EMG
0.0 | -0.066375732421875 | 0.0501125790304989
0.0004956722259521484 | -0.068817138671875 | 0.050582930433198614
0.0009894371032714844 | -0.068817138671875 | 0.051048946800198544
0.0014853477478027344 | -0.068817138671875 | 0.05151074586957316
0.001981496810913086 | -0.08056640625 | 0.052149145134267494
0.002477407455444336 | -0.08056640625 | 0.05277926106864143
0.003468751907348633 | -0.08056640625 | 0.05340142569004268
0.0039653778076171875 | -0.08453369140625 | 0.05408484882839751
0.004461050033569336 | -0.08453369140625 | 0.05475887083525851
0.004956960678100586 | -0.08453369140625 | 0.05542389654131085
0.0054531097412109375 | -0.08453369140625 | 0.05607634476471782
0.005949497222900391 | -0.08453369140625 | 0.05672078430808865
0.00842905044555664 | -0.0787353515625 | 0.057269280918808306
0.008928298950195312 | -0.07080078125 | 0.05770554354535352
0.009424209594726562 | -0.07080078125 | 0.05813852453056741
0.009920120239257812 | -0.07080078125 | 0.058568297007519976
0.01041555404663086 | -0.0677490234375 | 0.05895983016347974
0.010909557342529297 | -0.0677490234375 | 0.05934875468706889
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
