anwaypimpalkar/pneumatactors/TLC Valves/EFS LHDA Specs from Handbook.pdf

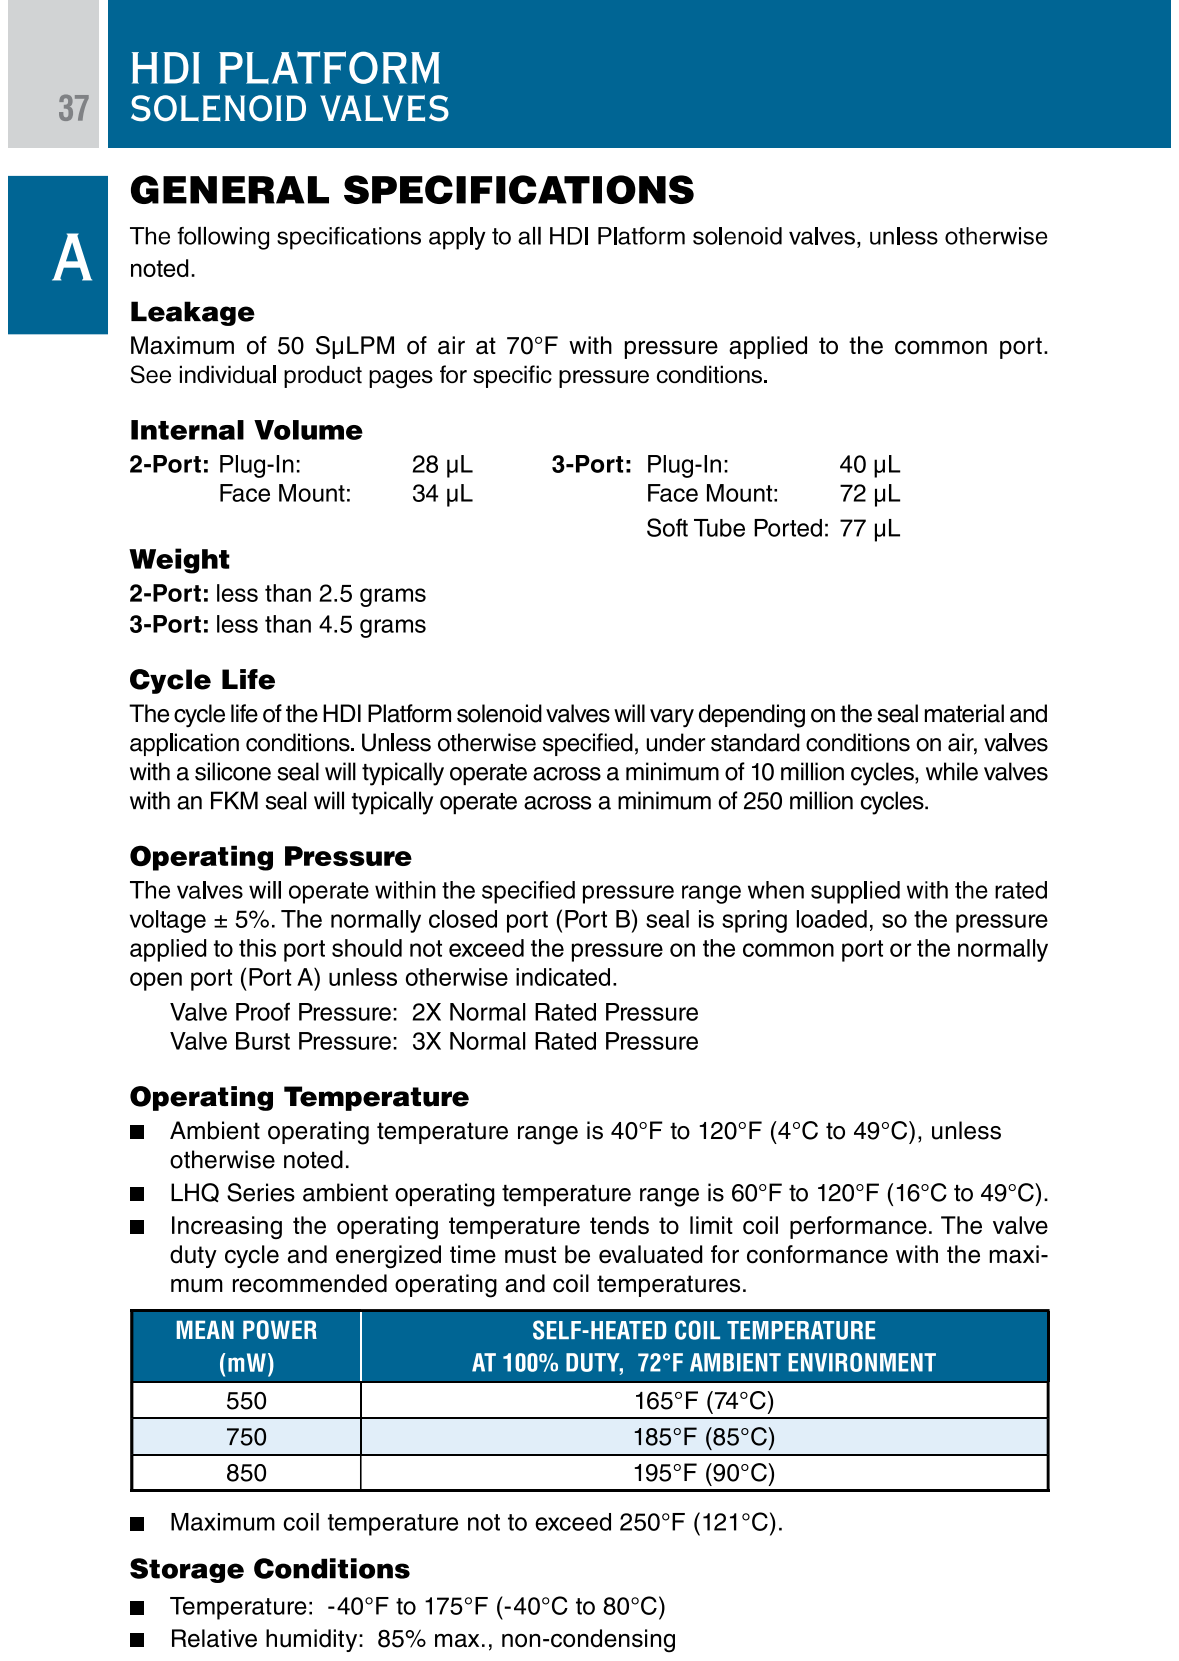
[picture p52: page 1]

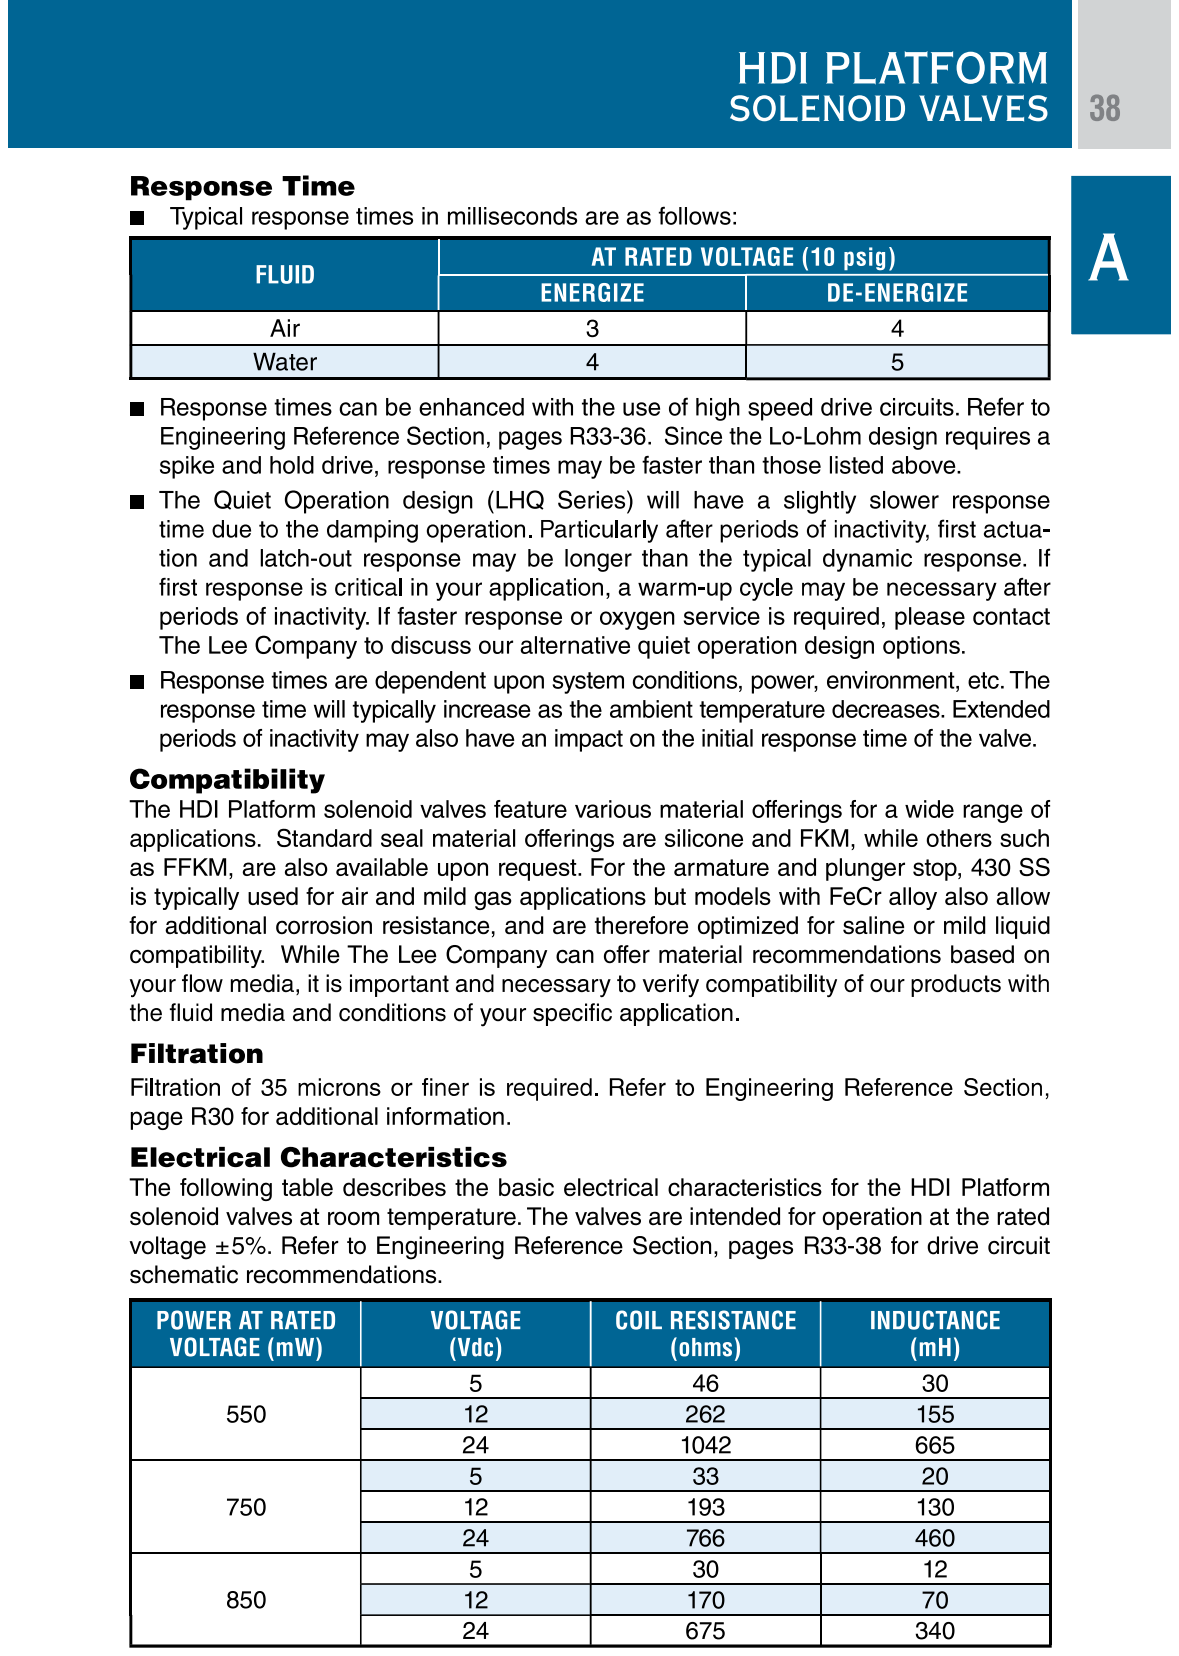
[picture p53: page 2]

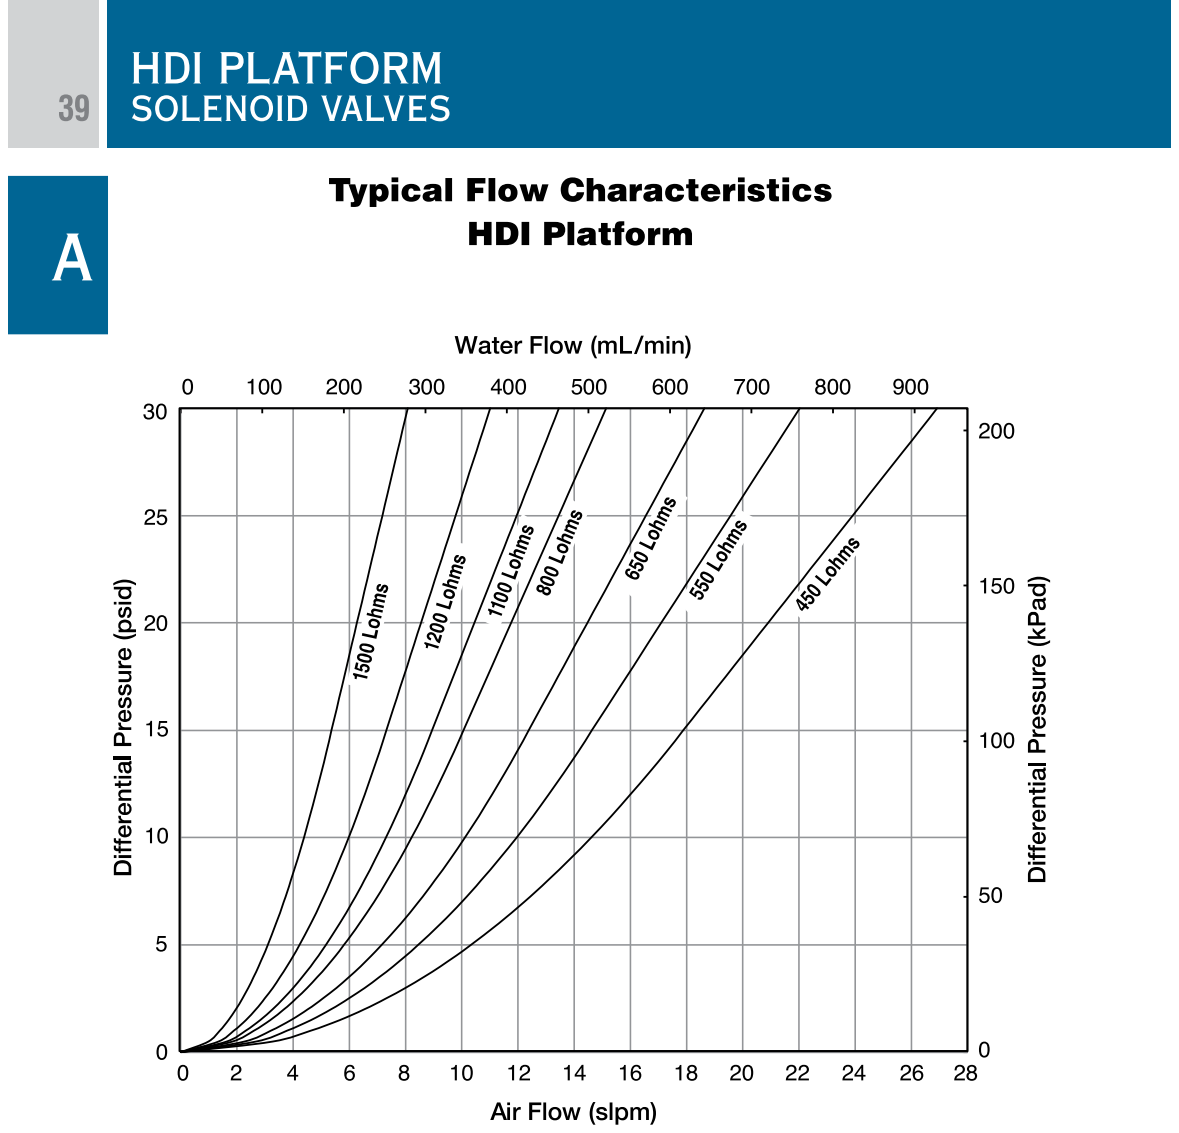
[picture p54: page 3]

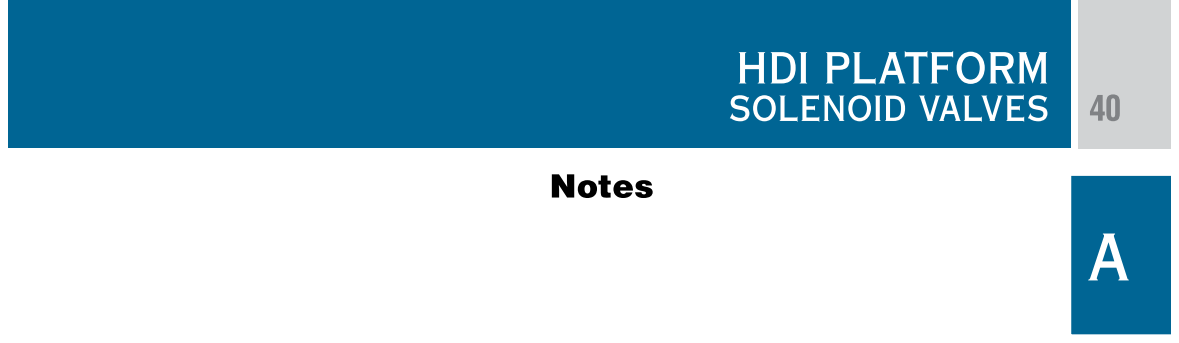
[picture p55: page 4]
