anwaypimpalkar/pneumatactors/TLC Valves/HDI Conventional Models.pdf

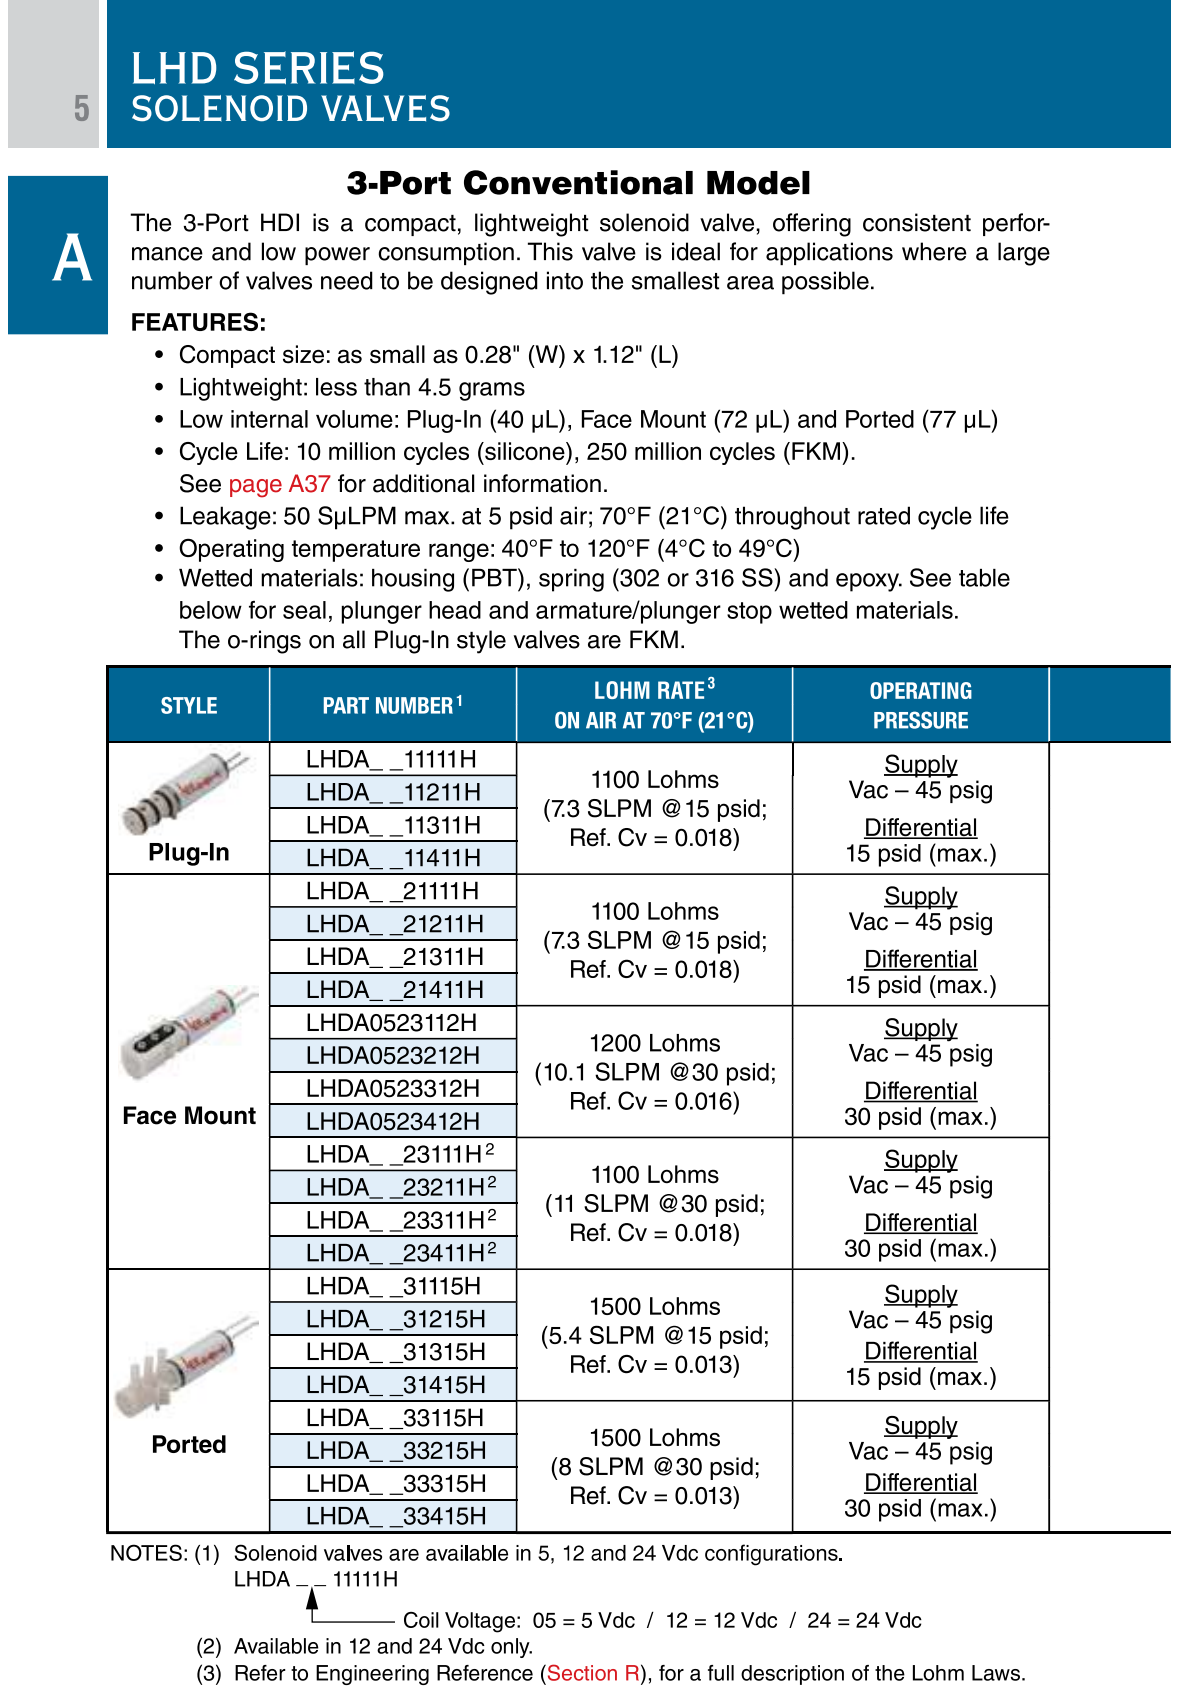
[picture p56: page 1]

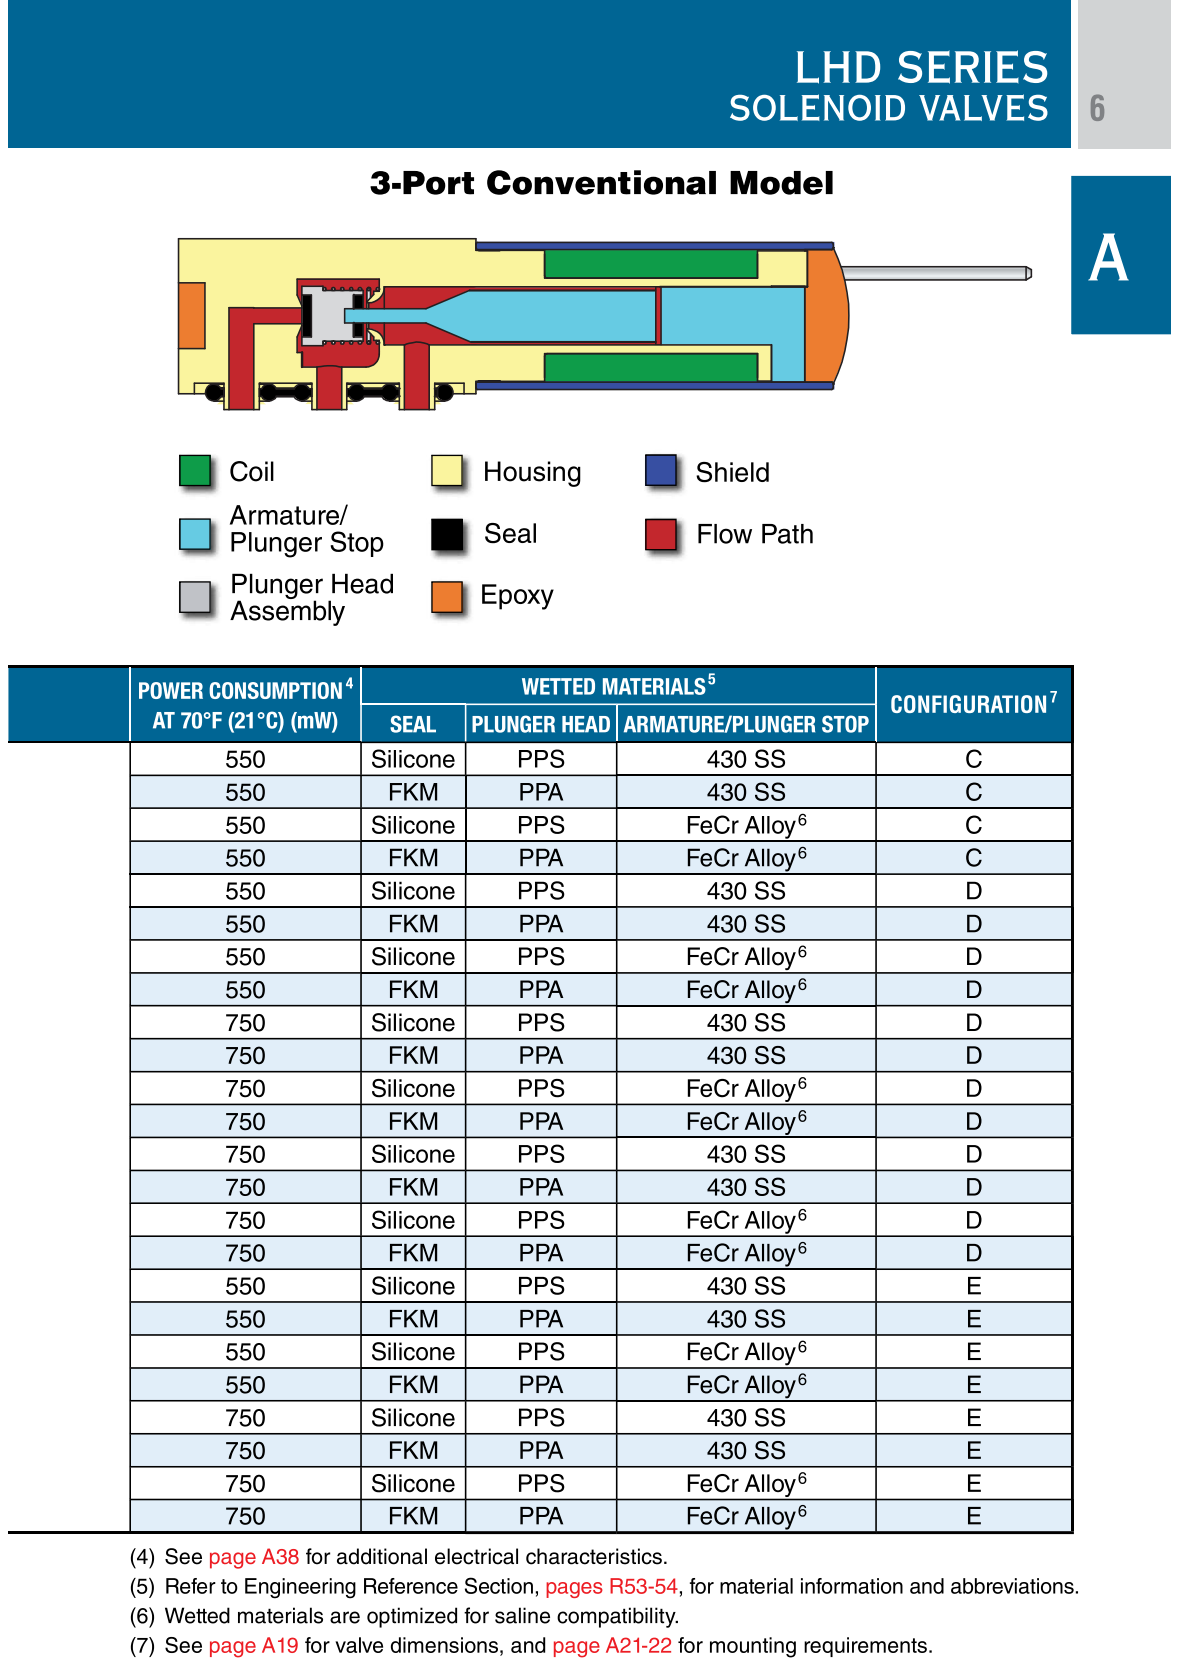
[picture p57: page 2]
