anwaypimpalkar/pneumatactors/PCBs/Pneumatactors_1Xiao_3PiezoPumps_6Valves_TwoPiece/Pneumatactors_1Xiao_3PiezoPumps_6Valves_TwoPiece.kicad_pcb

## KiCad design PCBs/Pneumatactors_1Xiao_3PiezoPumps_6Valves_TwoPiece/Pneumatactors_1Xiao_3PiezoPumps_6Valves_TwoPiece.kicad_pcb (2025-06-20)

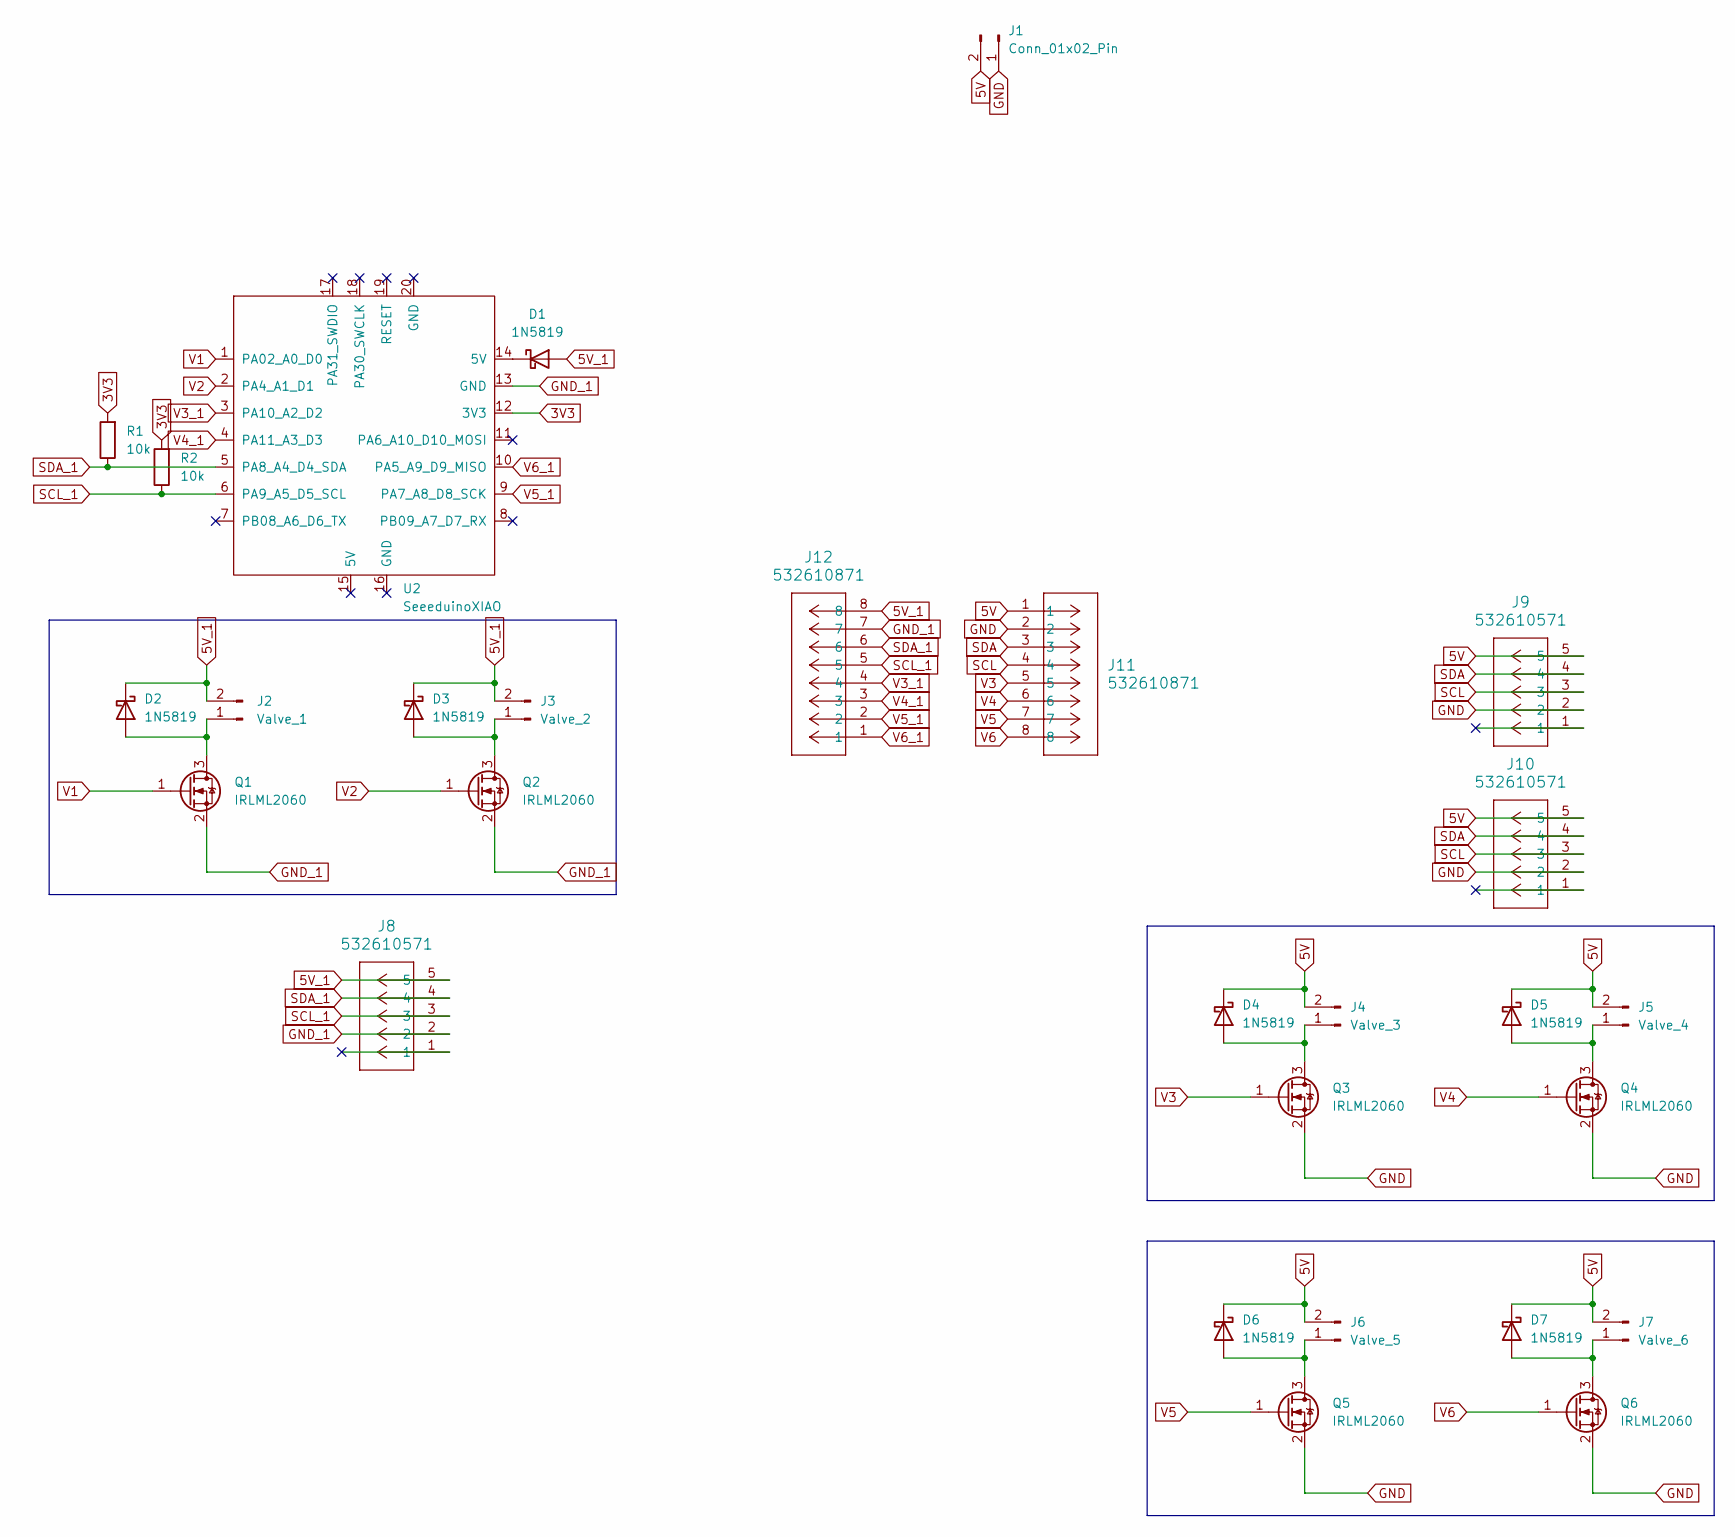
[picture p58: schematic Pneumatactors_1Xiao_3PiezoPumps_6Valves_TwoPiece.kicad_sch]

Parts:
D1, D2, D3, D4, D5, D6, D7: 1N5819; D_SMA
J1: Conn_01x02_Pin; PinHeader_1x02_P2.54mm_Vertical
J2: Valve_1; CONN02_533984002_MOL
J3: Valve_2; CONN02_533984002_MOL
J4: Valve_3; CONN02_533984002_MOL
J5: Valve_4; CONN02_533984002_MOL
J6: Valve_5; CONN02_533984002_MOL
J7: Valve_6; CONN02_533984002_MOL
J8, J9, J10: 532610571; CONN_532610001-SD_05_MOL
J11, J12: 532610871; CONN08_533980871_MOL
Q1, Q2, Q3, Q4, Q5, Q6: IRLML2060; SOT-23
R1, R2: 10k; R_1206_3216Metric_Pad1.30x1.75mm_HandSolder
U2: SeeeduinoXIAO; XIAO-ESP32S3-SMD

Connections:
3V3: R1.2, R2.2, U2.12 (3V3)
5V: D4.1 (K), D5.1 (K), D6.1 (K), D7.1 (K), J1.2, J4.2, J5.2, J6.2, J7.2, J9.5, J10.5, J11.1
5V_1: D1.2 (A), D2.1 (K), D3.1 (K), J2.2, J3.2, J8.5, J12.8
GND: J1.1, J9.2, J10.2, J11.2, Q3.2 (S), Q4.2 (S), Q5.2 (S), Q6.2 (S)
GND_1: J8.2, J12.7, Q1.2 (S), Q2.2 (S), U2.13 (GND)
unnamed: D1.1 (K), U2.14 (5V)
unnamed: D2.2 (A), J2.1, Q1.3 (D)
unnamed: D3.2 (A), J3.1, Q2.3 (D)
unnamed: D4.2 (A), J4.1, Q3.3 (D)
unnamed: D5.2 (A), J5.1, Q4.3 (D)
unnamed: D6.2 (A), J6.1, Q5.3 (D)
unnamed: D7.2 (A), J7.1, Q6.3 (D)
SCL: J9.3, J10.3, J11.4
SCL_1: J8.3, J12.5, R2.1, U2.6 (PA9_A5_D5_SCL)
SDA: J9.4, J10.4, J11.3
SDA_1: J8.4, J12.6, R1.1, U2.5 (PA8_A4_D4_SDA)
V1: Q1.1 (G), U2.1 (PA02_A0_D0)
V2: Q2.1 (G), U2.2 (PA4_A1_D1)
V3: J11.5, Q3.1 (G)
V3_1: J12.4, U2.3 (PA10_A2_D2)
V4: J11.6, Q4.1 (G)
V4_1: J12.3, U2.4 (PA11_A3_D3)
V5: J11.7, Q5.1 (G)
V5_1: J12.2, U2.9 (PA7_A8_D8_SCK)
V6: J11.8, Q6.1 (G)
V6_1: J12.1, U2.10 (PA5_A9_D9_MISO)

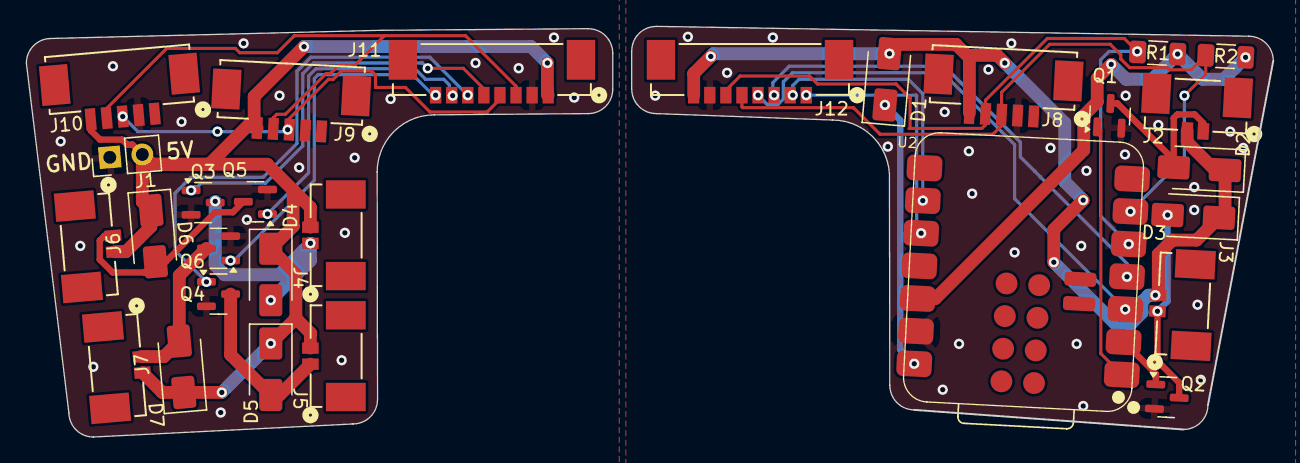
[picture p59: board Pneumatactors_1Xiao_3PiezoPumps_6Valves_TwoPiece.kicad_pcb from above]

Board: 2 copper layers, 97.0 x 31.9 mm, 28 parts (0 on the bottom side), 26 nets.
