anwaypimpalkar/pneumatactors/PCBs/Pneumatactors_1Xiao_3Pumps_8Valves/Pneumatactors_1Xiao_3Pumps_8Valves.kicad_pcb

## KiCad design PCBs/Pneumatactors_1Xiao_3Pumps_8Valves/Pneumatactors_1Xiao_3Pumps_8Valves.kicad_pcb (2025-06-20)

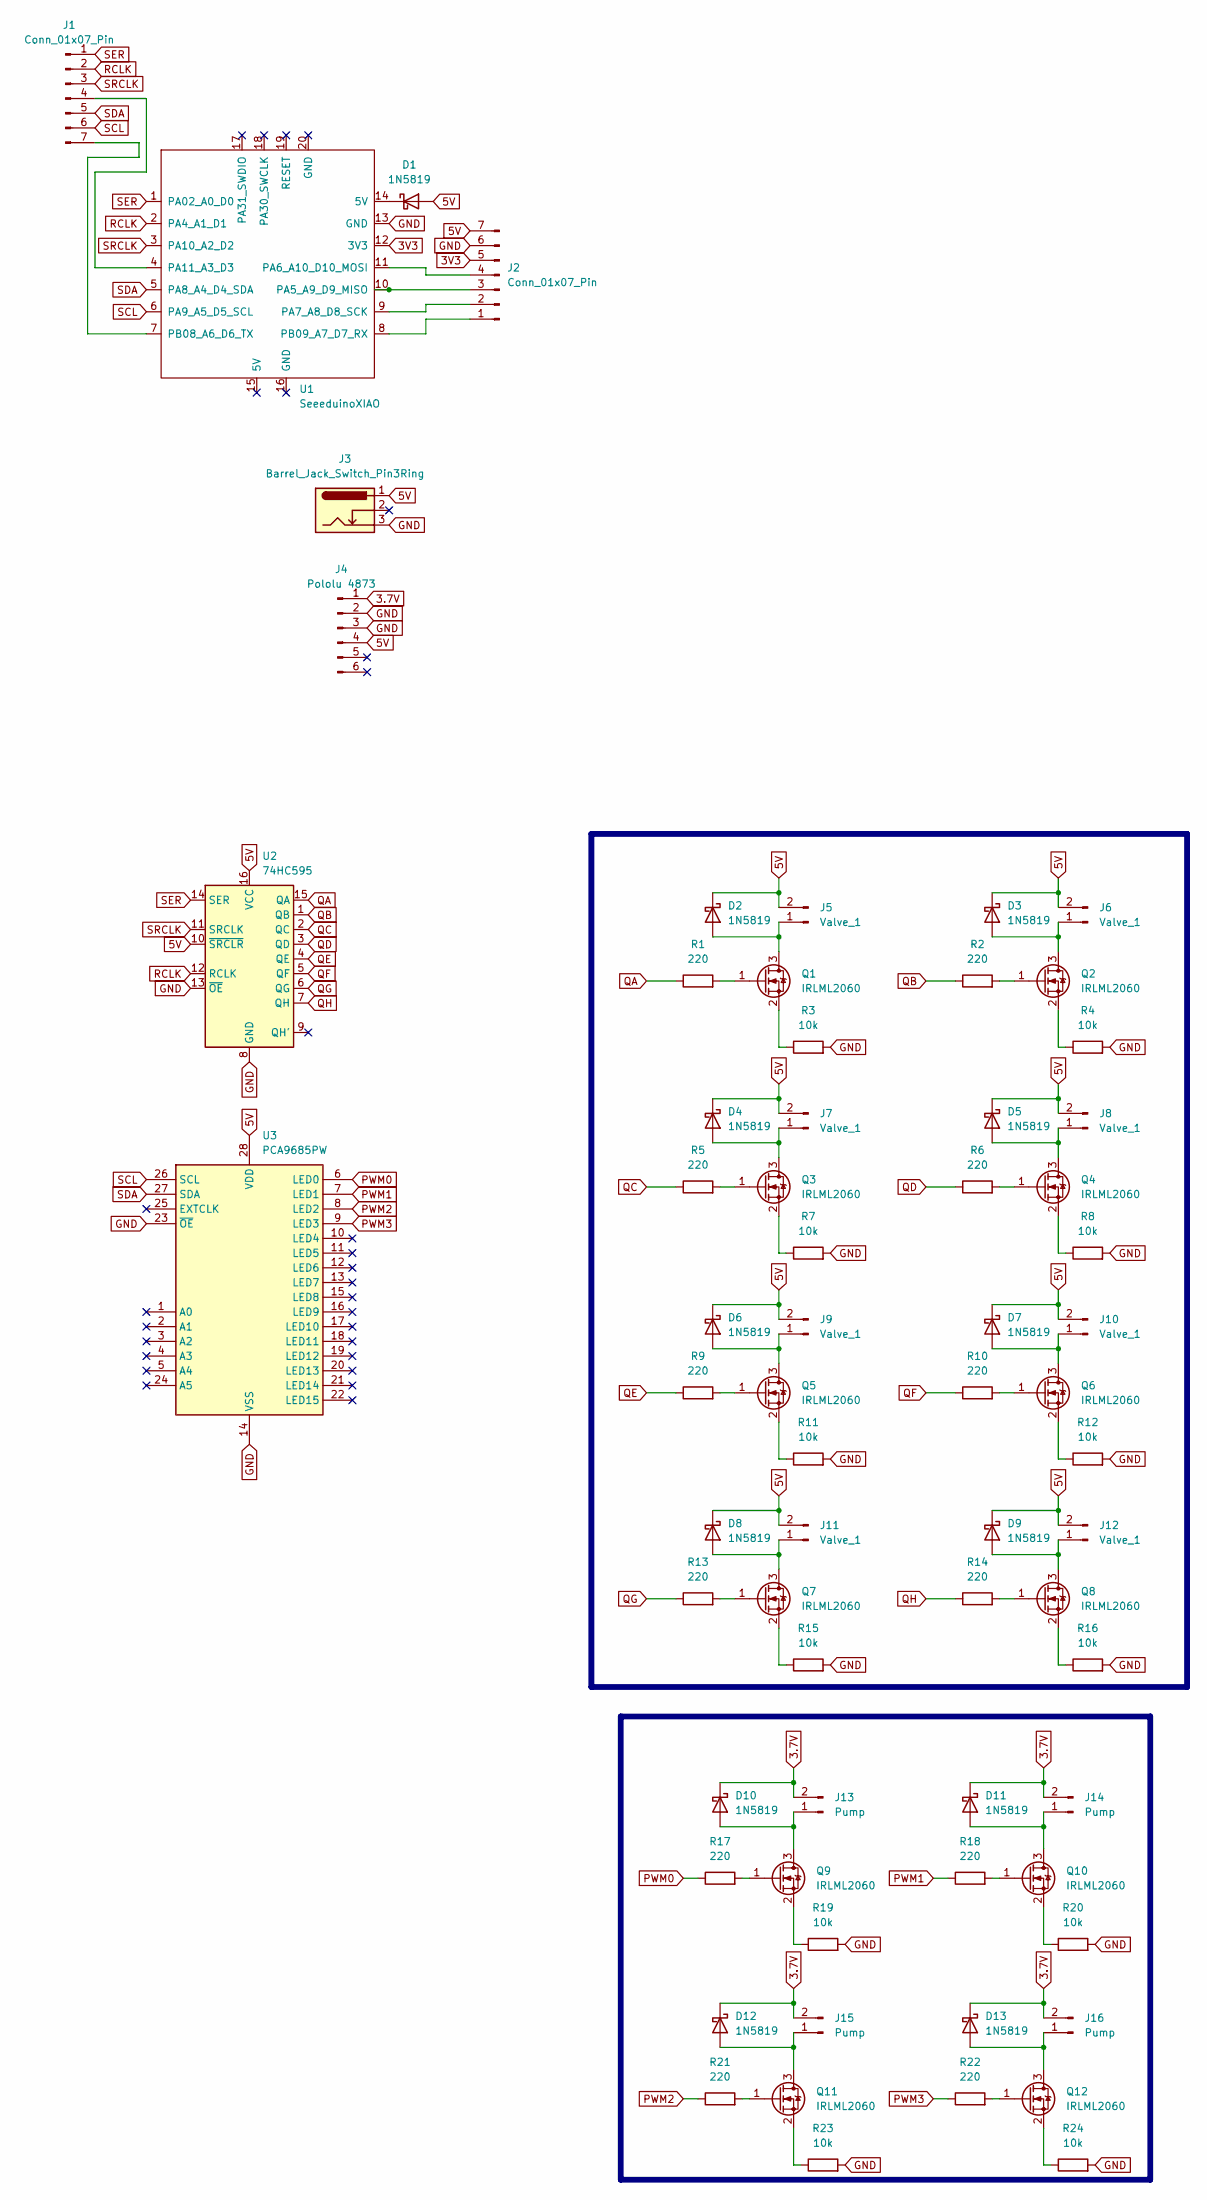
[picture p60: schematic Pneumatactors_1Xiao_3Pumps_8Valves.kicad_sch]

Parts:
D1, D2, D3, D4, D5, D6, D7, D8, D9, D10, D11, D12, D13: 1N5819; D_SMA
J1, J2: Conn_01x07_Pin; PinHeader_1x07_P2.54mm_Vertical
J3: Barrel_Jack_Switch_Pin3Ring; PJ-002A_CUD
J4: Pololu 4873; PinHeader_1x06_P2.54mm_Vertical
J5, J6, J7, J8, J9, J10, J11, J12: Valve_1; JST_PH_S2B-PH-SM4-TB_1x02-1MP_P2.00mm_Horizontal
J13, J14, J15, J16: Pump; JST_PH_S2B-PH-SM4-TB_1x02-1MP_P2.00mm_Horizontal
Q1, Q2, Q3, Q4, Q5, Q6, Q7, Q8, Q9, Q10, Q11, Q12: IRLML2060; SOT-23
R1, R2, R5, R6, R9, R10, R13, R14, R17, R18, R21, R22: 220; R_1206_3216Metric_Pad1.30x1.75mm_HandSolder
R3, R4, R7, R8, R11, R12, R15, R16, R19, R20, R23, R24: 10k; R_1206_3216Metric_Pad1.30x1.75mm_HandSolder
U1: SeeeduinoXIAO; XIAO-ESP32S3-SMD
U2: 74HC595; SSOP-16_5.3x6.2mm_P0.65mm
U3: PCA9685PW; TSSOP-28_4.4x9.7mm_P0.65mm

Connections:
3.7V: D10.1 (K), D11.1 (K), D12.1 (K), D13.1 (K), J4.1, J13.2, J14.2, J15.2, J16.2
3V3: J2.5, U1.12 (3V3)
5V: D1.2 (A), D2.1 (K), D3.1 (K), D4.1 (K), D5.1 (K), D6.1 (K), D7.1 (K), D8.1 (K), D9.1 (K), J2.7, J3.1, J4.4, J5.2, J6.2, J7.2, J8.2, J9.2, J10.2, J11.2, J12.2, U2.10 (~SRCLR), U2.16 (VCC), U3.28 (VDD)
GND: J2.6, J3.3, J4.2, J4.3, R3.2, R4.2, R7.2, R8.2, R11.2, R12.2, R15.2, R16.2, R19.2, R20.2, R23.2, R24.2, U1.13 (GND), U2.8 (GND), U2.13 (~OE), U3.14 (VSS), U3.23 (~OE)
unnamed: D1.1 (K), U1.14 (5V)
unnamed: D2.2 (A), J5.1, Q1.3 (D)
unnamed: D3.2 (A), J6.1, Q2.3 (D)
unnamed: D4.2 (A), J7.1, Q3.3 (D)
unnamed: D5.2 (A), J8.1, Q4.3 (D)
unnamed: D6.2 (A), J9.1, Q5.3 (D)
unnamed: D7.2 (A), J10.1, Q6.3 (D)
unnamed: D8.2 (A), J11.1, Q7.3 (D)
unnamed: D9.2 (A), J12.1, Q8.3 (D)
unnamed: D10.2 (A), J13.1, Q9.3 (D)
unnamed: D11.2 (A), J14.1, Q10.3 (D)
unnamed: D12.2 (A), J15.1, Q11.3 (D)
unnamed: D13.2 (A), J16.1, Q12.3 (D)
unnamed: J1.4, U1.4 (PA11_A3_D3)
unnamed: J1.7, U1.7 (PB08_A6_D6_TX)
unnamed: J2.1, U1.8 (PB09_A7_D7_RX)
unnamed: J2.2, U1.9 (PA7_A8_D8_SCK)
unnamed: J2.3, U1.10 (PA5_A9_D9_MISO)
unnamed: J2.4, U1.11 (PA6_A10_D10_MOSI)
unnamed: Q1.1 (G), R1.2
unnamed: Q1.2 (S), R3.1
unnamed: Q2.1 (G), R2.2
unnamed: Q2.2 (S), R4.1
unnamed: Q3.1 (G), R5.2
unnamed: Q3.2 (S), R7.1
unnamed: Q4.1 (G), R6.2
unnamed: Q4.2 (S), R8.1
unnamed: Q5.1 (G), R9.2
unnamed: Q5.2 (S), R11.1
unnamed: Q6.1 (G), R10.2
unnamed: Q6.2 (S), R12.1
unnamed: Q7.1 (G), R13.2
unnamed: Q7.2 (S), R15.1
unnamed: Q8.1 (G), R14.2
unnamed: Q8.2 (S), R16.1
unnamed: Q9.1 (G), R17.2
unnamed: Q9.2 (S), R19.1
unnamed: Q10.1 (G), R18.2
unnamed: Q10.2 (S), R20.1
unnamed: Q11.1 (G), R21.2
unnamed: Q11.2 (S), R23.1
unnamed: Q12.1 (G), R22.2
unnamed: Q12.2 (S), R24.1
PWM0: R17.1, U3.6 (LED0)
PWM1: R18.1, U3.7 (LED1)
PWM2: R21.1, U3.8 (LED2)
PWM3: R22.1, U3.9 (LED3)
QA: R1.1, U2.15 (QA)
QB: R2.1, U2.1 (QB)
QC: R5.1, U2.2 (QC)
QD: R6.1, U2.3 (QD)
QE: R9.1, U2.4 (QE)
QF: R10.1, U2.5 (QF)
QG: R13.1, U2.6 (QG)
QH: R14.1, U2.7 (QH)
RCLK: J1.2, U1.2 (PA4_A1_D1), U2.12 (RCLK)
SCL: J1.6, U1.6 (PA9_A5_D5_SCL), U3.26 (SCL)
SDA: J1.5, U1.5 (PA8_A4_D4_SDA), U3.27 (SDA)
SER: J1.1, U1.1 (PA02_A0_D0), U2.14 (SER)
SRCLK: J1.3, U1.3 (PA10_A2_D2), U2.11 (SRCLK)

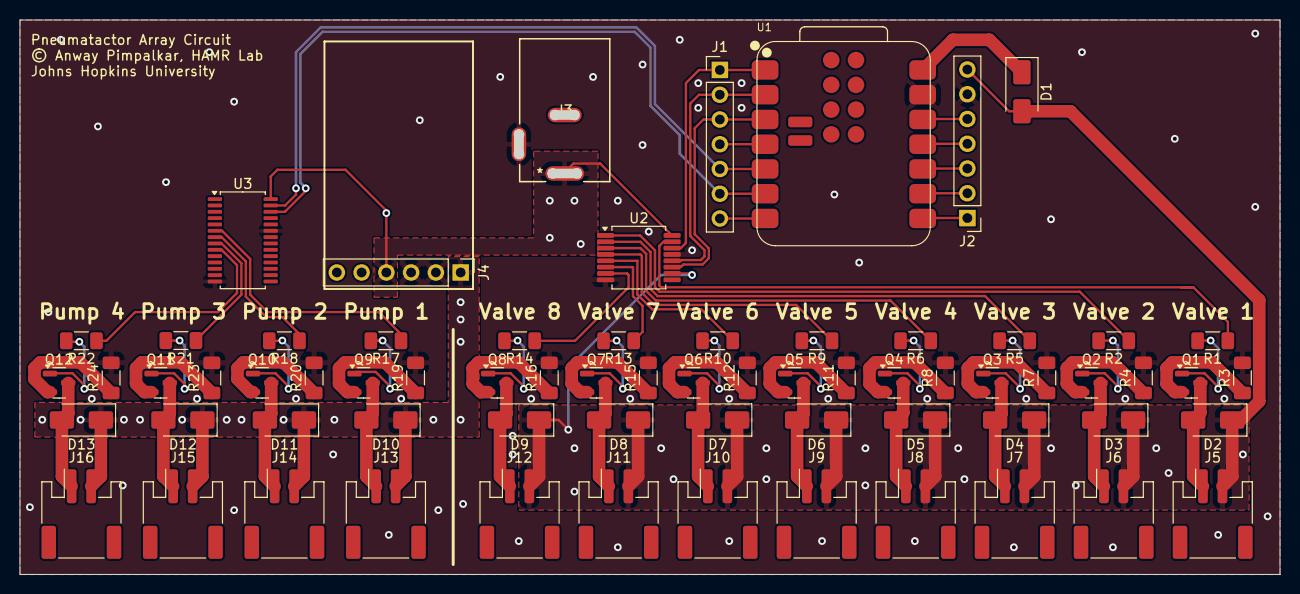
[picture p61: board Pneumatactors_1Xiao_3Pumps_8Valves.kicad_pcb from above]

Board: 2 copper layers, 129.3 x 56.9 mm, 68 parts (0 on the bottom side), 64 nets.
