anwaypimpalkar/pneumatactors/PCBs/Pneumatactor_WiredPressureSensing/Pneumatactor_WiredPressureSensing.kicad_pcb

## KiCad design PCBs/Pneumatactor_WiredPressureSensing/Pneumatactor_WiredPressureSensing.kicad_pcb (2025-06-20)

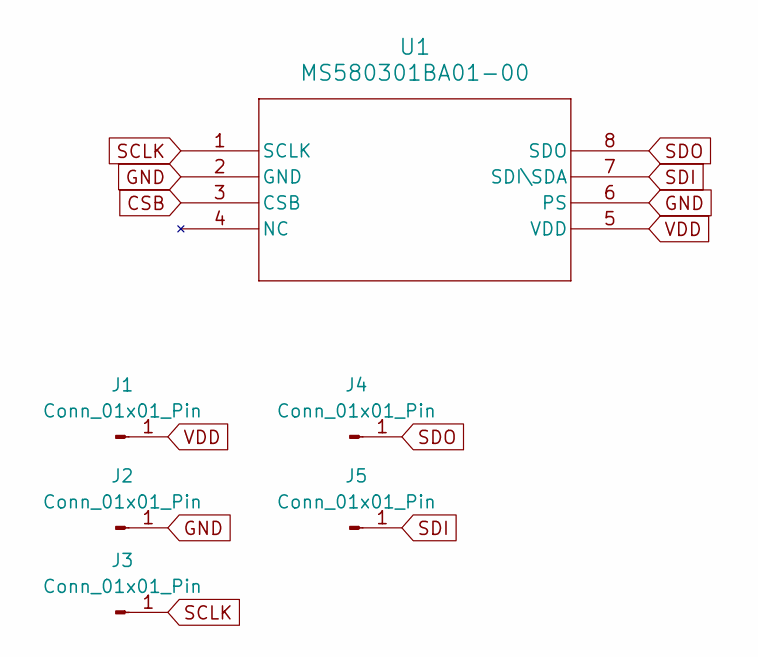
[picture p62: schematic Pneumatactor_WiredPressureSensing.kicad_sch]

Parts:
J1, J2, J3, J4, J5: Conn_01x01_Pin; SingleSMDPad
U1: MS580301BA01-00; MS5803-01BA01_TEC

Connections:
CSB: U1.3 (CSB)
GND: J2.1, U1.2 (GND), U1.6 (PS)
SCLK: J3.1, U1.1 (SCLK)
SDI: J5.1, U1.7 (SDI\SDA)
SDO: J4.1, U1.8 (SDO)
VDD: J1.1, U1.5 (VDD)

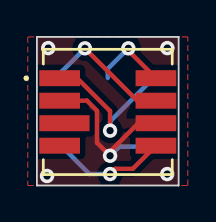
[picture p63: board Pneumatactor_WiredPressureSensing.kicad_pcb from above]

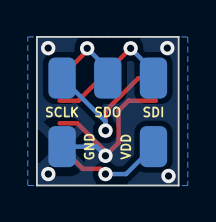
[picture p64: board Pneumatactor_WiredPressureSensing.kicad_pcb from below]

Board: 2 copper layers, 7.9 x 8.3 mm, 6 parts (5 on the bottom side), 5 nets.
