anwaypimpalkar/pneumatactors/PCBs/Pneumatactors_1Xiao_CompactControl_Battery/Pneumatactors_1Xiao_CompactControl_Battery.kicad_pcb

## KiCad design PCBs/Pneumatactors_1Xiao_CompactControl_Battery/Pneumatactors_1Xiao_CompactControl_Battery.kicad_pcb (2025-06-20)

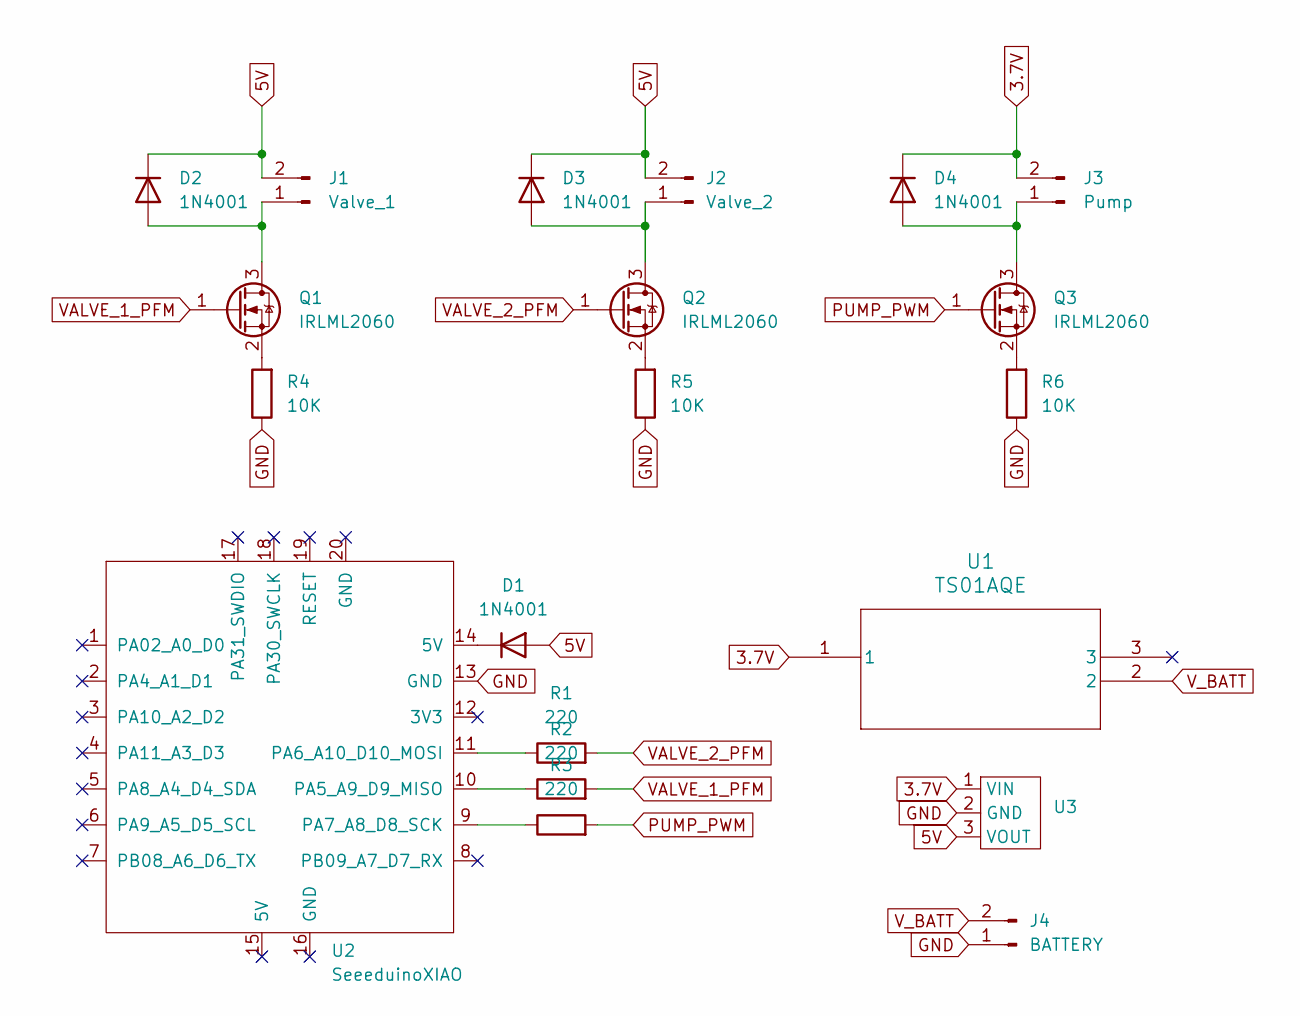
[picture p65: schematic Pneumatactors_1Xiao_CompactControl_Battery.kicad_sch]

Parts:
D1, D2, D3, D4: 1N4001; D_SOD-123F
J1: Valve_1; JST_PH_S2B-PH-SM4-TB_1x02-1MP_P2.00mm_Horizontal
J2: Valve_2; JST_PH_S2B-PH-SM4-TB_1x02-1MP_P2.00mm_Horizontal
J3: Pump; JST_PH_S2B-PH-SM4-TB_1x02-1MP_P2.00mm_Horizontal
J4: BATTERY; JST_PH_S2B-PH-SM4-TB_1x02-1MP_P2.00mm_Horizontal
Q1, Q2, Q3: IRLML2060; SOT-23
R1, R2, R3: 220; R_1206_3216Metric_Pad1.30x1.75mm_HandSolder
R4, R5, R6: 10K; R_1206_3216Metric_Pad1.30x1.75mm_HandSolder
U1: TS01AQE; SW3_TS01A
U2: SeeeduinoXIAO; XIAO-ESP32S3-SMD
U3: Pololu 2564 Step Up

Connections:
3.7V: D4.1 (K), J3.2, U1.1, U3.1 (VIN)
5V: D1.2 (A), D2.1 (K), D3.1 (K), J1.2, J2.2, U3.3 (VOUT)
GND: J4.1, R4.1, R5.1, R6.1, U2.13 (GND), U3.2 (GND)
unnamed: D1.1 (K), U2.14 (5V)
unnamed: D2.2 (A), J1.1, Q1.3 (D)
unnamed: D3.2 (A), J2.1, Q2.3 (D)
unnamed: D4.2 (A), J3.1, Q3.3 (D)
unnamed: Q1.2 (S), R4.2
unnamed: Q2.2 (S), R5.2
unnamed: Q3.2 (S), R6.2
unnamed: R2.1, U2.10 (PA5_A9_D9_MISO)
unnamed: R1.1, U2.11 (PA6_A10_D10_MOSI)
unnamed: R3.1, U2.9 (PA7_A8_D8_SCK)
PUMP_PWM: Q3.1 (G), R3.2
VALVE_1_PFM: Q1.1 (G), R2.2
VALVE_2_PFM: Q2.1 (G), R1.2
V_BATT: J4.2, U1.2

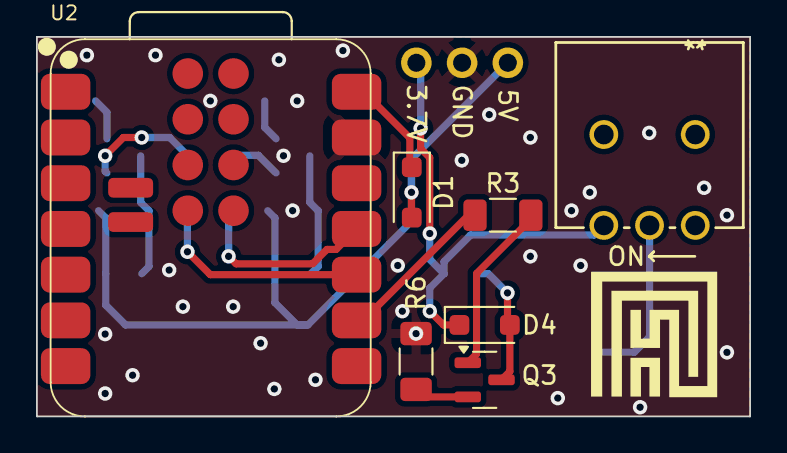
[picture p66: board Pneumatactors_1Xiao_CompactControl_Battery.kicad_pcb from above]

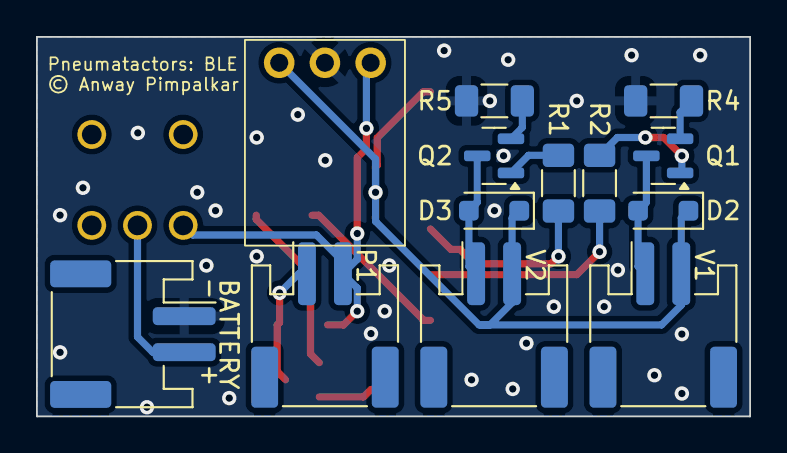
[picture p67: board Pneumatactors_1Xiao_CompactControl_Battery.kicad_pcb from below]

Board: 2 copper layers, 39.6 x 21.1 mm, 20 parts (13 on the bottom side), 17 nets.
