anwaypimpalkar/pneumatactors/PCBs/Pneumatactors_EmbeddedPressureSensing/Pneumatactors_EmbeddedPressureSensing.kicad_pcb

## KiCad design PCBs/Pneumatactors_EmbeddedPressureSensing/Pneumatactors_EmbeddedPressureSensing.kicad_pcb (2025-06-20)

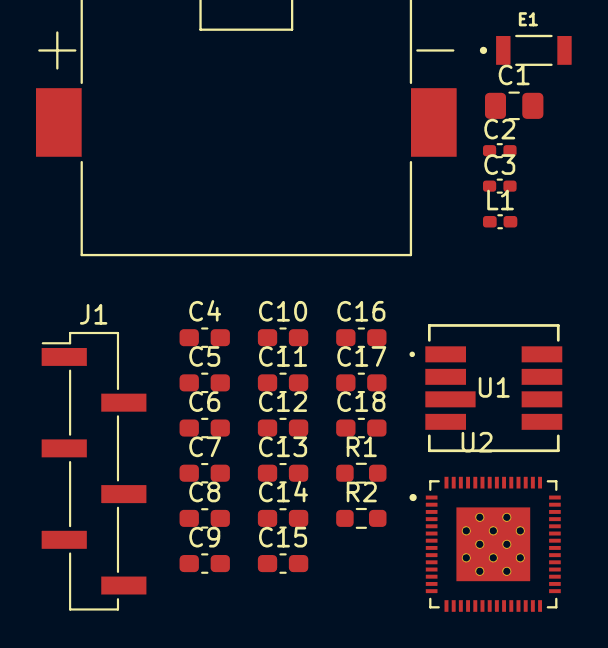
[picture p68: board Pneumatactors_EmbeddedPressureSensing.kicad_pcb from above]

Board: 2 copper layers, 26 parts (0 on the bottom side), 19 nets, no tracks yet.

Parts:
BT1: BHSD-1225-SM; BAT_BHSD-1225-SM
C1: 100u; C_0805_2012Metric_Pad1.18x1.45mm_HandSolder
C2: 1p; C_0402_1005Metric_Pad0.74x0.62mm_HandSolder
C3: 0.8p; C_0402_1005Metric_Pad0.74x0.62mm_HandSolder
C4, C5, C7, C9, C11, C14, C17: 0.1u; C_0603_1608Metric_Pad1.08x0.95mm_HandSolder
C6: 10u; C_0603_1608Metric_Pad1.08x0.95mm_HandSolder
C8, C10, C12, C13, C15, C16, C18: 1u; C_0603_1608Metric_Pad1.08x0.95mm_HandSolder
E1: 2450AT18B100E; XDCR_2450AT18B100E
J1: Conn_01x06_Pin; PinHeader_1x06_P2.54mm_Vertical_SMD_Pin1Left
L1: 3.9n; L_0402_1005Metric_Pad0.77x0.64mm_HandSolder
R1, R2: 10k; R_0603_1608Metric_Pad0.98x0.95mm_HandSolder
U1: MS580301BA01-00; MS5803-01BA01_TEC
U2: ESP32-S3; IC_ESP32-S3

Connections:
CHIP_PU: BT1.-, C1.1, C4.1, C5.1, C7.1, C9.1, C11.1, C12.1, C14.1, C15.1, C17.1, C18.1, J1.4, U1.2 (GND), U1.6 (PS), U2.4 (CHIP_PU), U2.5 (GPIO0), U2.57 (GND)
CSB: U1.3 (CSB), U2.10 (GPIO5)
LNA_IN: C2.1, U2.1 (LNA_IN)
unnamed: C2.2, L1.1
unnamed: C3.1, L1.2
unnamed: C3.2, E1.1
unnamed: C6.1, C7.2
unnamed: C8.1, C9.2
unnamed: C10.1, C11.2
unnamed: C13.1, C14.2
unnamed: C16.1, C17.2
unnamed: C4.2, J1.5, R1.1
unnamed: C5.2, J1.6, R2.1
SCLK: U1.1 (SCLK), U2.33 (SPICLK)
SDI: U1.7 (SDI\SDA), U2.35 (SPID)
SDO: U1.8 (SDO), U2.34 (SPIQ)
U0RXD: J1.3, U2.50 (U0RXD)
U0TXD: J1.2, U2.49 (U0TXD)
VDD: BT1.+, C1.2, C6.2, C8.2, C10.2, C12.2, C13.2, C15.2, C16.2, C18.2, J1.1, R1.2, R2.2, U1.5 (VDD), U2.2 (VDD3P3), U2.3 (VDD3P3__1), U2.20 (VDD3P3_RTC), U2.29 (VDD_SPI), U2.46 (VDD3P3_CPU), U2.55 (VDDA1), U2.56 (VDDA2)
