anwaypimpalkar/pneumatactors/PCBs/Pneumatactors_1Xiao_CompactControl/Pneumatactors_1Xiao_CompactControl.kicad_pcb

## KiCad design PCBs/Pneumatactors_1Xiao_CompactControl/Pneumatactors_1Xiao_CompactControl.kicad_pcb (2025-06-20)

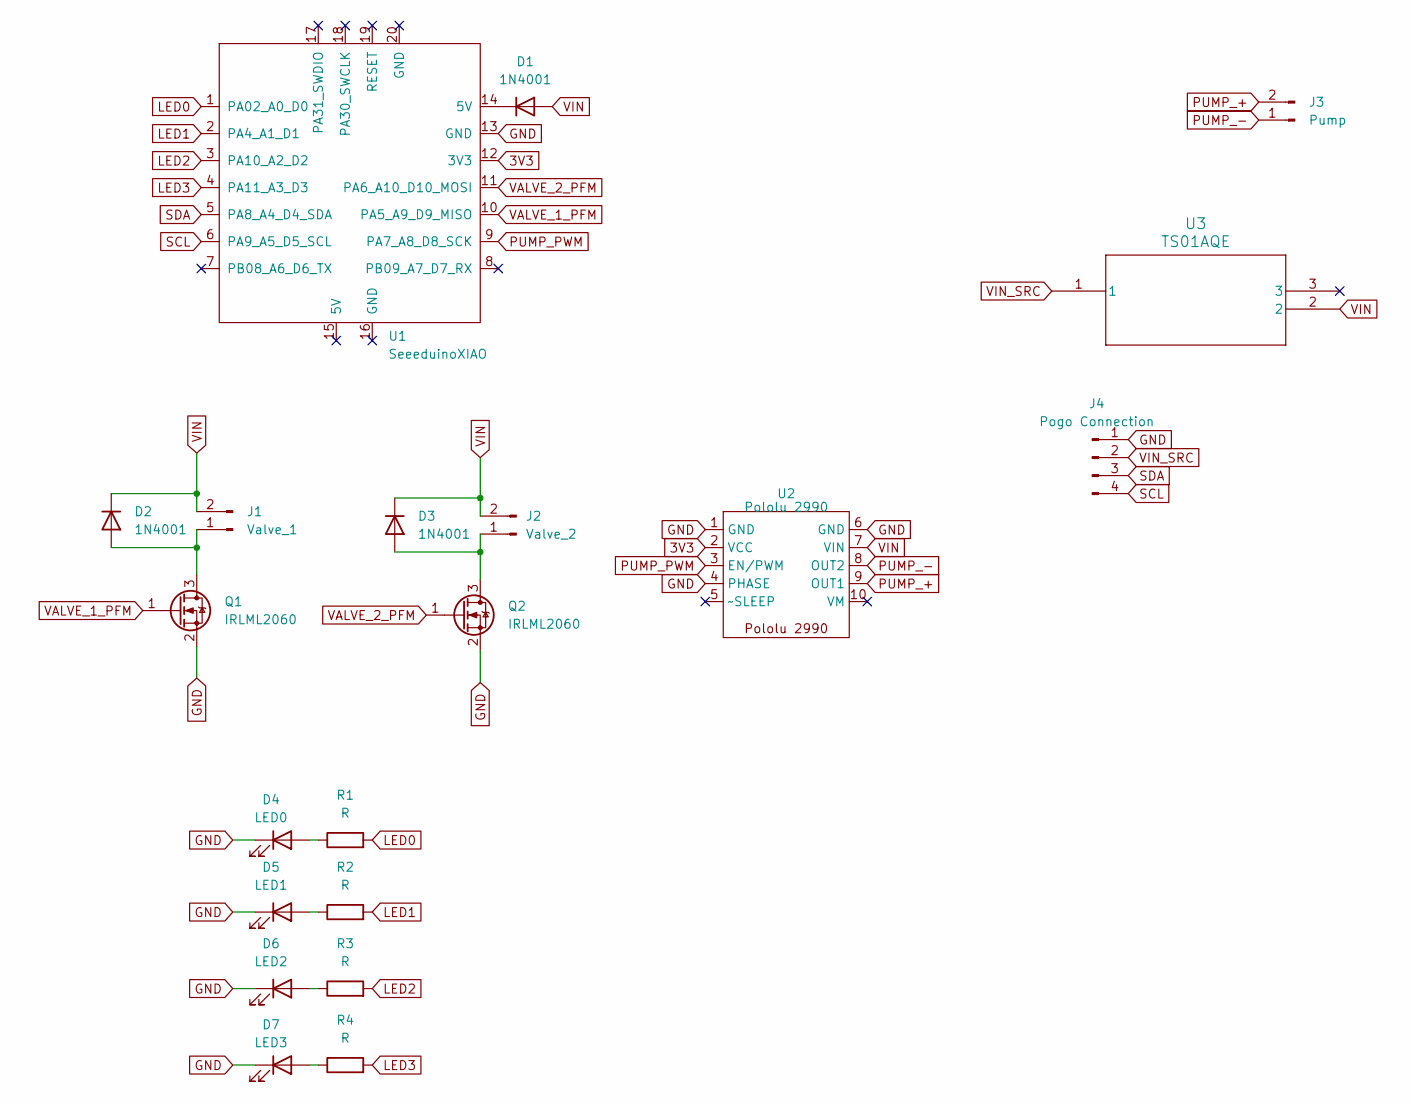
[picture p69: schematic Pneumatactors_1Xiao_CompactControl.kicad_sch]

Parts:
D1, D2, D3: 1N4001; D_SOD-123F
D4: LED0; LED_0201_0603Metric_Pad0.64x0.40mm_HandSolder
D5: LED1; LED_0201_0603Metric_Pad0.64x0.40mm_HandSolder
D6: LED2; LED_0201_0603Metric_Pad0.64x0.40mm_HandSolder
D7: LED3; LED_0201_0603Metric_Pad0.64x0.40mm_HandSolder
J1: Valve_1; PinHeader_1x02_P2.54mm_Vertical
J2: Valve_2; PinHeader_1x02_P2.54mm_Vertical
J3: Pump; PinHeader_1x02_P2.54mm_Vertical
J4: Pogo Connection; PinHeader_1x04_P2.54mm_Vertical
Q1, Q2: IRLML2060; SOT-23
R1, R2, R3, R4: R; R_0201_0603Metric_Pad0.64x0.40mm_HandSolder
U1: SeeeduinoXIAO; XIAO-Generic-Thruhole-14P-2.54-21X17.8MM
U2: Pololu 2990; Pololu 2990 Motor Driver
U3: TS01AQE; SW3_TS01A

Connections:
3V3: U1.12 (3V3), U2.2 (VCC)
GND: D4.1 (K), D5.1 (K), D6.1 (K), D7.1 (K), J4.1, Q1.2 (S), Q2.2 (S), U1.13 (GND), U2.1 (GND), U2.4 (PHASE), U2.6 (GND)
LED0: R1.2, U1.1 (PA02_A0_D0)
LED1: R2.2, U1.2 (PA4_A1_D1)
LED2: R3.2, U1.3 (PA10_A2_D2)
LED3: R4.2, U1.4 (PA11_A3_D3)
unnamed: D1.1 (K), U1.14 (5V)
unnamed: D2.2 (A), J1.1, Q1.3 (D)
unnamed: D3.2 (A), J2.1, Q2.3 (D)
unnamed: D4.2 (A), R1.1
unnamed: D5.2 (A), R2.1
unnamed: D6.2 (A), R3.1
unnamed: D7.2 (A), R4.1
PUMP_+: J3.2, U2.9 (OUT1)
PUMP_-: J3.1, U2.8 (OUT2)
PUMP_PWM: U1.9 (PA7_A8_D8_SCK), U2.3 (EN/PWM)
SCL: J4.4, U1.6 (PA9_A5_D5_SCL)
SDA: J4.3, U1.5 (PA8_A4_D4_SDA)
VALVE_1_PFM: Q1.1 (G), U1.10 (PA5_A9_D9_MISO)
VALVE_2_PFM: Q2.1 (G), U1.11 (PA6_A10_D10_MOSI)
VIN: D1.2 (A), D2.1 (K), D3.1 (K), J1.2, J2.2, U2.7 (VIN), U3.2
VIN_SRC: J4.2, U3.1

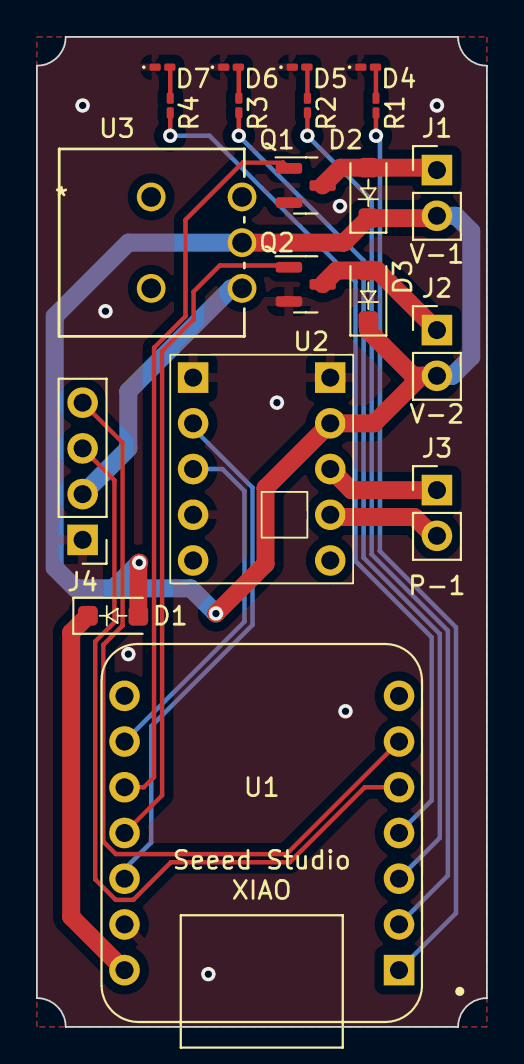
[picture p70: board Pneumatactors_1Xiao_CompactControl.kicad_pcb from above]

Board: 2 copper layers, 25.0 x 55.0 mm, 20 parts (0 on the bottom side), 22 nets.
