anwaypimpalkar/pneumatactors/PCBs/Pneumatactors_1Xiao_2PiezoPumps_2Valves/Pneumatactors_1Xiao_PiezoPumps_2Valves.kicad_pcb

## KiCad design PCBs/Pneumatactors_1Xiao_2PiezoPumps_2Valves/Pneumatactors_1Xiao_PiezoPumps_2Valves.kicad_pcb (2025-06-20)

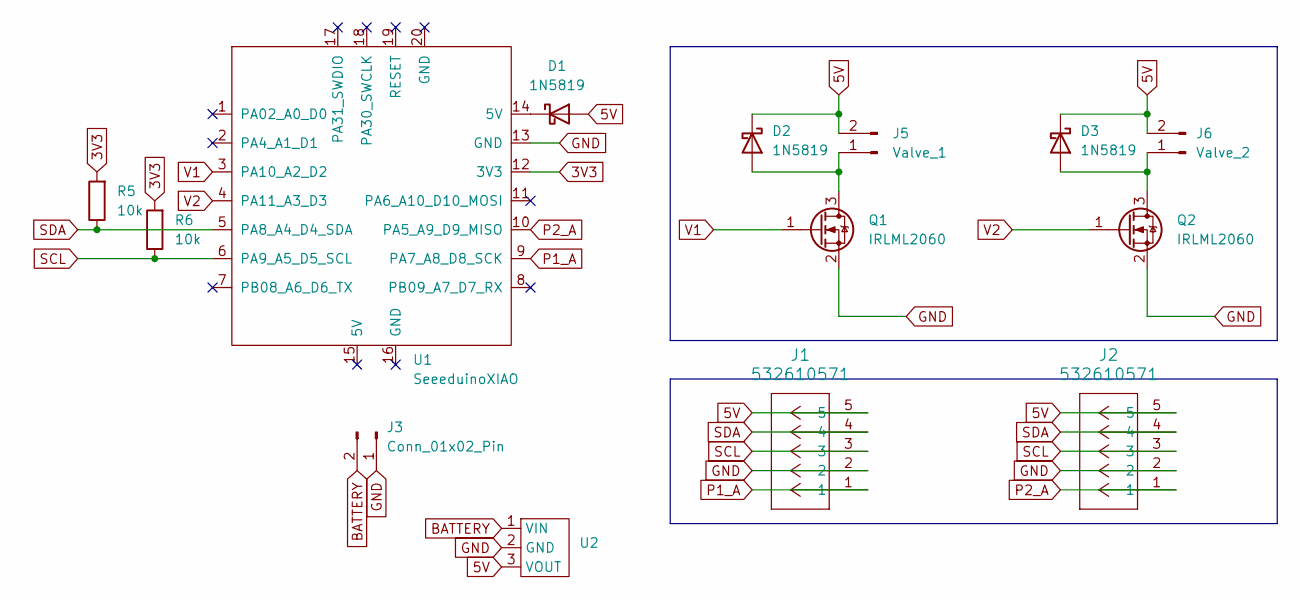
[picture p71: schematic Pneumatactors_1Xiao_PiezoPumps_2Valves.kicad_sch]

Parts:
D1, D2, D3: 1N5819; D_SMA
J1, J2: 532610571; CONN_532610001-SD_05_MOL
J3: Conn_01x02_Pin; JST_PH_S2B-PH-SM4-TB_1x02-1MP_P2.00mm_Horizontal
J5: Valve_1; CONN_532610001-SD_02_MOL
J6: Valve_2; CONN_532610001-SD_02_MOL
Q1, Q2: IRLML2060; SOT-23
R5, R6: 10k; R_1206_3216Metric_Pad1.30x1.75mm_HandSolder
U1: SeeeduinoXIAO; XIAO-ESP32S3-SMD
U2: Pololu 2564 Step Up

Connections:
3V3: R5.2, R6.2, U1.12 (3V3)
5V: D1.2 (A), D2.1 (K), D3.1 (K), J1.5, J2.5, J5.2, J6.2, U2.3 (VOUT)
BATTERY: J3.2, U2.1 (VIN)
GND: J1.2, J2.2, J3.1, Q1.2 (S), Q2.2 (S), U1.13 (GND), U2.2 (GND)
unnamed: D1.1 (K), U1.14 (5V)
unnamed: D2.2 (A), J5.1, Q1.3 (D)
unnamed: D3.2 (A), J6.1, Q2.3 (D)
P1_A: J1.1, U1.9 (PA7_A8_D8_SCK)
P2_A: J2.1, U1.10 (PA5_A9_D9_MISO)
SCL: J1.3, J2.3, R6.1, U1.6 (PA9_A5_D5_SCL)
SDA: J1.4, J2.4, R5.1, U1.5 (PA8_A4_D4_SDA)
V1: Q1.1 (G), U1.3 (PA10_A2_D2)
V2: Q2.1 (G), U1.4 (PA11_A3_D3)

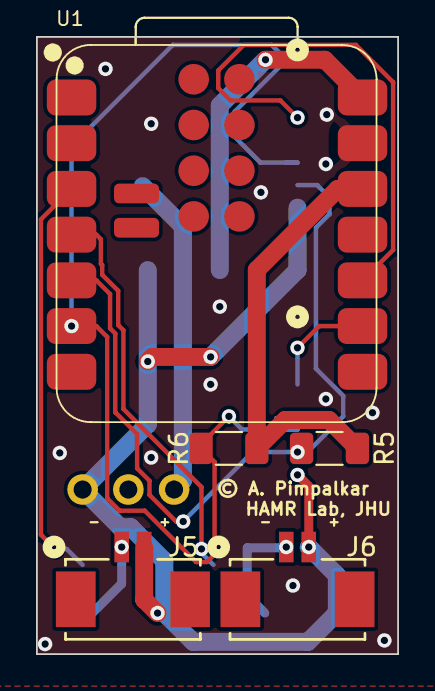
[picture p72: board Pneumatactors_1Xiao_PiezoPumps_2Valves.kicad_pcb from above]

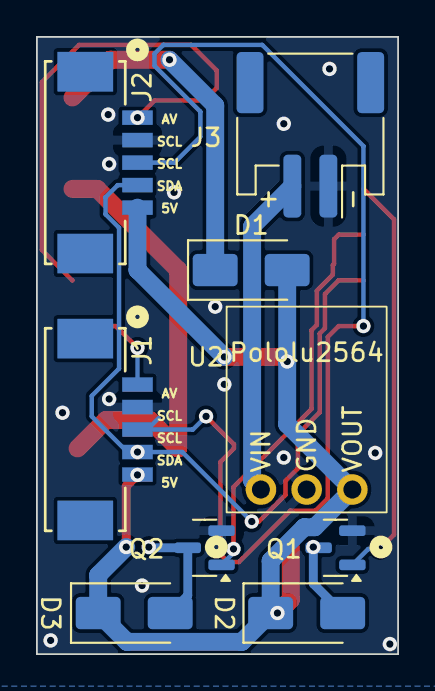
[picture p73: board Pneumatactors_1Xiao_PiezoPumps_2Valves.kicad_pcb from below]

Board: 2 copper layers, 20.1 x 34.3 mm, 14 parts (9 on the bottom side), 13 nets.
