anwaypimpalkar/pneumatactors/PCBs/Pneumatactors_NanoEvery_PumpControl/Pneumatactors_NanoEvery_PumpControl.kicad_pcb

## KiCad design PCBs/Pneumatactors_NanoEvery_PumpControl/Pneumatactors_NanoEvery_PumpControl.kicad_pcb (2025-03-29)

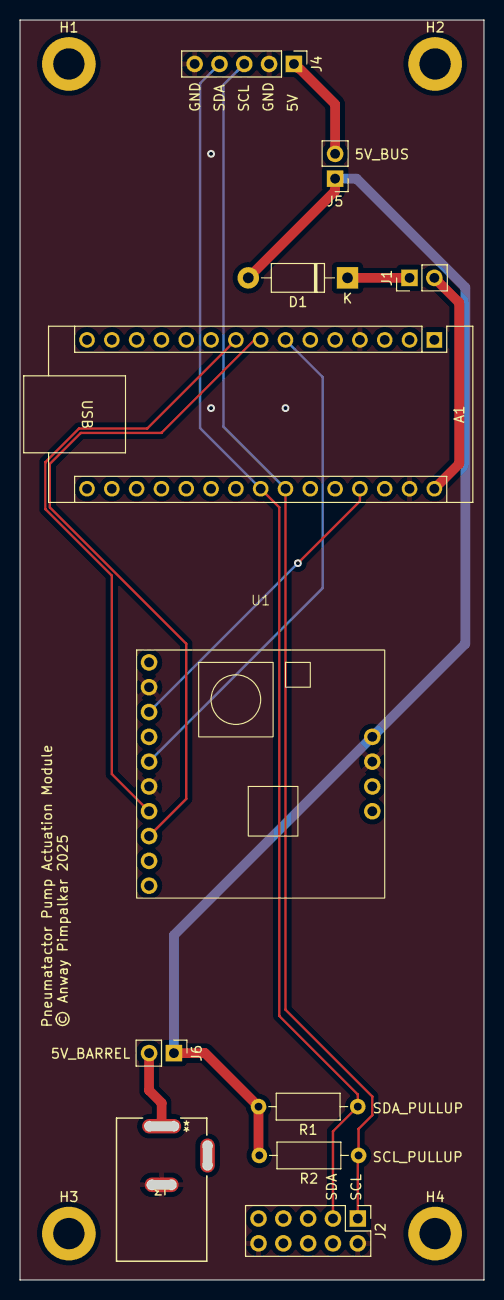
[picture p74: board Pneumatactors_NanoEvery_PumpControl.kicad_pcb from above]

Board: 2 copper layers, 47.5 x 129.0 mm, 15 parts (0 on the bottom side), 12 nets.

Parts:
A1: Arduino_Nano_Every; Arduino_Nano
D1: 1N4001; D_DO-41_SOD81_P10.16mm_Horizontal
H1, H2, H3, H4: MountingHole; MountingHole_3.2mm_M3_ISO14580_Pad
J1, J5, J6: Conn_01x02_Pin; PinHeader_1x02_P2.54mm_Vertical
J2: Conn_02x05_Odd_Even; PinHeader_2x05_P2.54mm_Vertical
J3: PJ-002A; PJ-002A_CUD
J4: Conn_01x05_Pin; PinHeader_1x05_P2.54mm_Vertical
R1, R2: R; R_Axial_DIN0207_L6.3mm_D2.5mm_P10.16mm_Horizontal
U1: Pololu 2997 Motor Driver

Connections:
5V: D1.2 (A), J5.1, J6.1, R1.2, R2.2, U1.11 (VIN)
5V_BARREL: J3.1, J6.2
5V_BUS: J4.1, J5.2
5V_NANO: A1.27 (+5V), U1.3 (VCC)
EN: A1.7 (D4), U1.5 (EN)
GND: A1.4 (GND), A1.29 (GND), J2.2, J2.10, J3.2, J4.2, J4.5, U1.2 (GND), U1.6 (ENB), U1.12 (GND)
unnamed: A1.30 (VIN), J1.2
unnamed: D1.1 (K), J1.1
PWM1: A1.8 (D5), U1.8 (PWM1)
PWM2: A1.9 (D6), U1.7 (PWM2)
SCL: A1.24 (SCL/A5), J2.1, J4.3, R2.1
SDA: A1.23 (SDA/A4), J2.3, J4.4, R1.1
