anwaypimpalkar/pneumatactors/PCBs/Pneumatactors_4Xiao_ValveControl/Pneumatactors_4Xiao_ValveControl.kicad_pcb

## KiCad design PCBs/Pneumatactors_4Xiao_ValveControl/Pneumatactors_4Xiao_ValveControl.kicad_pcb (2025-03-06)

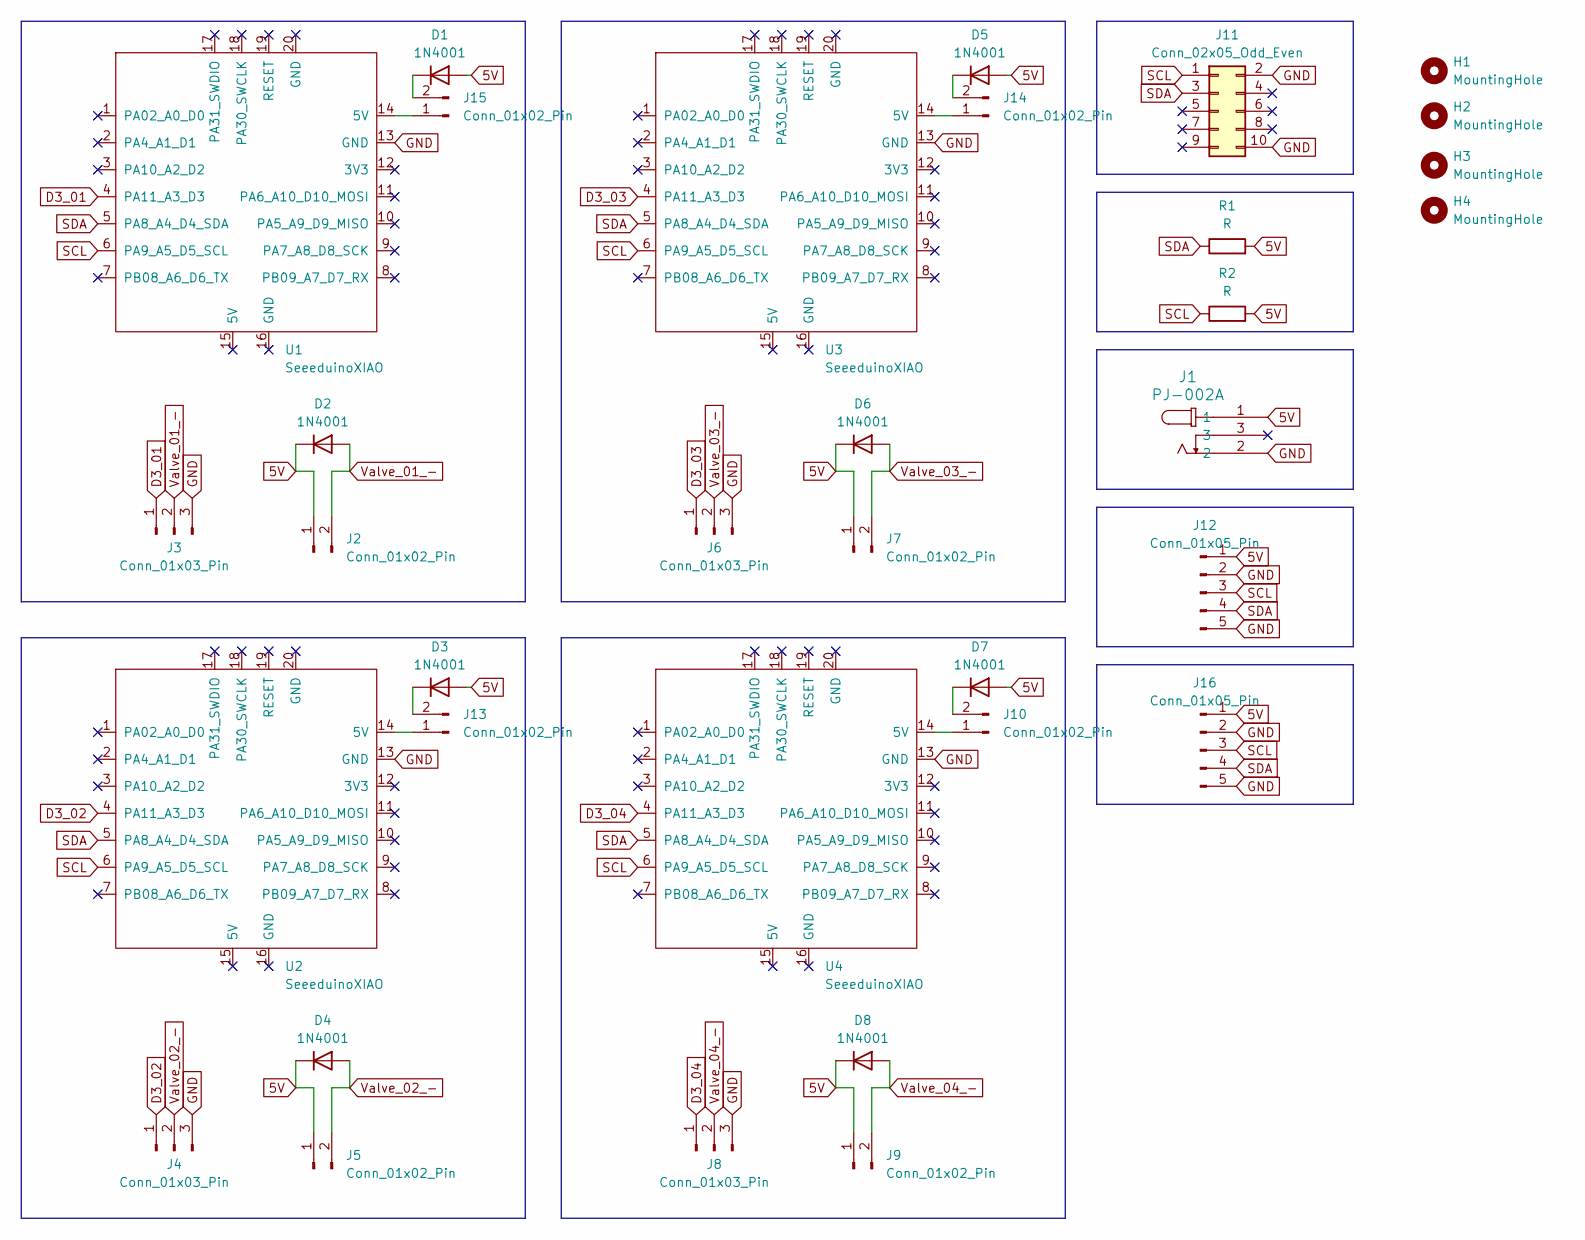
[picture p75: schematic Pneumatactors_4Xiao_ValveControl.kicad_sch]

Parts:
D1, D2, D3, D4, D5, D6, D7, D8: 1N4001; D_DO-41_SOD81_P10.16mm_Horizontal
H1, H2, H3, H4: MountingHole; MountingHole_3.2mm_M3_ISO14580_Pad
J1: PJ-002A; PJ-002A_CUD
J2, J5, J7, J9, J10, J13, J14, J15: Conn_01x02_Pin; PinHeader_1x02_P2.54mm_Vertical
J3, J4, J6, J8: Conn_01x03_Pin; PinHeader_1x03_P2.54mm_Vertical
J11: Conn_02x05_Odd_Even; PinHeader_2x05_P2.54mm_Vertical
J12, J16: Conn_01x05_Pin; PinHeader_1x05_P2.54mm_Vertical
R1, R2: R; R_Axial_DIN0207_L6.3mm_D2.5mm_P10.16mm_Horizontal
U1, U2, U3, U4: SeeeduinoXIAO; XIAO-Generic-Thruhole-14P-2.54-21X17.8MM

Connections:
5V: D1.2 (A), D2.1 (K), D3.2 (A), D4.1 (K), D5.2 (A), D6.1 (K), D7.2 (A), D8.1 (K), J1.1, J2.1, J5.1, J7.1, J9.1, J12.1, J16.1, R1.2, R2.2
D3_01: J3.1, U1.4 (PA11_A3_D3)
D3_02: J4.1, U2.4 (PA11_A3_D3)
D3_03: J6.1, U3.4 (PA11_A3_D3)
D3_04: J8.1, U4.4 (PA11_A3_D3)
GND: J1.2, J3.3, J4.3, J6.3, J8.3, J11.2, J11.10, J12.2, J12.5, J16.2, J16.5, U1.13 (GND), U2.13 (GND), U3.13 (GND), U4.13 (GND)
unnamed: D1.1 (K), J15.2
unnamed: D3.1 (K), J13.2
unnamed: D5.1 (K), J14.2
unnamed: D7.1 (K), J10.2
unnamed: J10.1, U4.14 (5V)
unnamed: J13.1, U2.14 (5V)
unnamed: J14.1, U3.14 (5V)
unnamed: J15.1, U1.14 (5V)
SCL: J11.1, J12.3, J16.3, R2.1, U1.6 (PA9_A5_D5_SCL), U2.6 (PA9_A5_D5_SCL), U3.6 (PA9_A5_D5_SCL), U4.6 (PA9_A5_D5_SCL)
SDA: J11.3, J12.4, J16.4, R1.1, U1.5 (PA8_A4_D4_SDA), U2.5 (PA8_A4_D4_SDA), U3.5 (PA8_A4_D4_SDA), U4.5 (PA8_A4_D4_SDA)
Valve_01_-: D2.2 (A), J2.2, J3.2
Valve_02_-: D4.2 (A), J4.2, J5.2
Valve_03_-: D6.2 (A), J6.2, J7.2
Valve_04_-: D8.2 (A), J8.2, J9.2

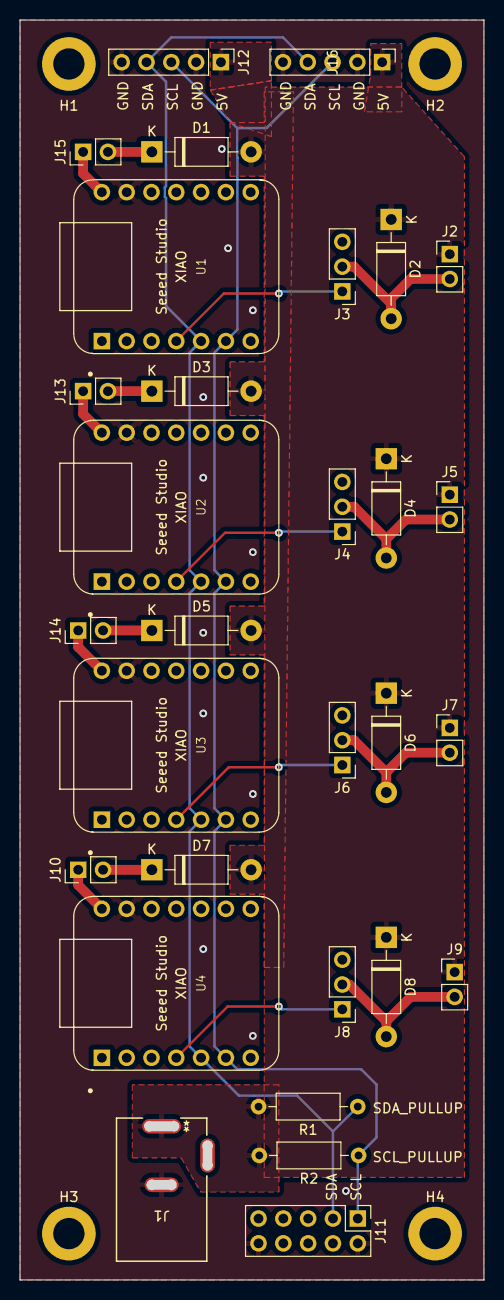
[picture p76: board Pneumatactors_4Xiao_ValveControl.kicad_pcb from above]

Board: 2 copper layers, 47.5 x 129.0 mm, 34 parts (0 on the bottom side), 20 nets.
