anwaypimpalkar/pneumatactors/PCBs/Pneumatactors_1Xiao_ValveControl/Pneumatactors_1Xiao_ValveControl.kicad_pcb

## KiCad design PCBs/Pneumatactors_1Xiao_ValveControl/Pneumatactors_1Xiao_ValveControl.kicad_pcb (2025-03-06)

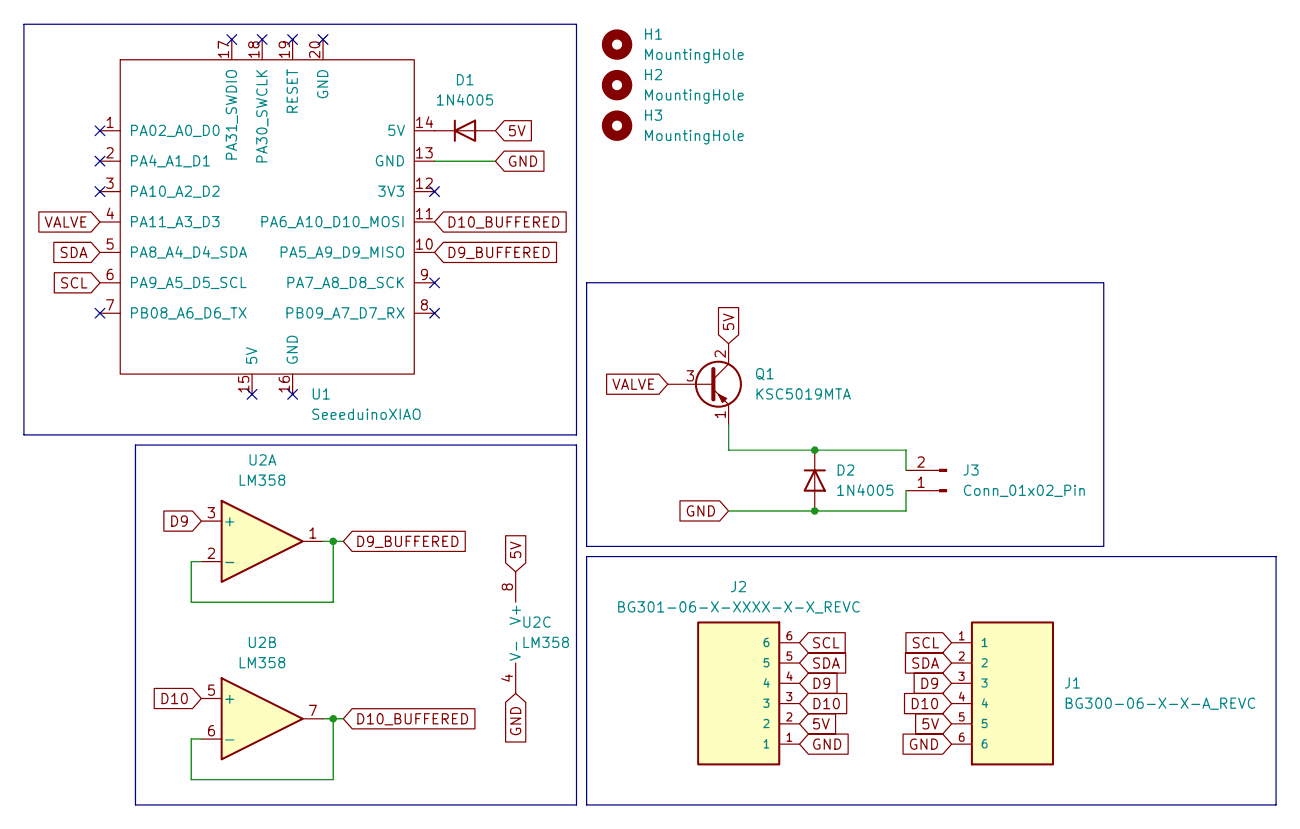
[picture p77: schematic Pneumatactors_1Xiao_ValveControl.kicad_sch]

Parts:
D1, D2: 1N4005; D_DO-41_SOD81_P10.16mm_Horizontal
H1, H2, H3: MountingHole; MountingHole_2.2mm_M2_ISO14580
J1: BG300-06-X-X-A_REVC; GCT_BG300-06-X-X-A_REVC
J2: BG301-06-X-XXXX-X-X_REVC; GCT_BG301-06-X-XXXX-X-X_REVC
J3: Conn_01x02_Pin; PinHeader_1x02_P2.54mm_Vertical
Q1: KSC5019MTA; TO-92L_Inline_Wide
U1: SeeeduinoXIAO; XIAO-Generic-Thruhole-14P-2.54-21X17.8MM
U2: LM358; SOIC_58BAIDR_TEX_LM358

Connections:
5V: D1.2 (A), J1.5, J2.2, Q1.2 (C), U2.8 (V+)
D9: J1.3, J2.4, U2.3 (+)
D9_BUFFERED: U1.10 (PA5_A9_D9_MISO), U2.1, U2.2 (-)
D10: J1.4, J2.3, U2.5 (+)
D10_BUFFERED: U1.11 (PA6_A10_D10_MOSI), U2.6 (-), U2.7
GND: D2.2 (A), J1.6, J2.1, J3.1, U1.13 (GND), U2.4 (V-)
unnamed: D1.1 (K), U1.14 (5V)
unnamed: D2.1 (K), J3.2, Q1.1 (E)
SCL: J1.1, J2.6, U1.6 (PA9_A5_D5_SCL)
SDA: J1.2, J2.5, U1.5 (PA8_A4_D4_SDA)
VALVE: Q1.3 (B), U1.4 (PA11_A3_D3)

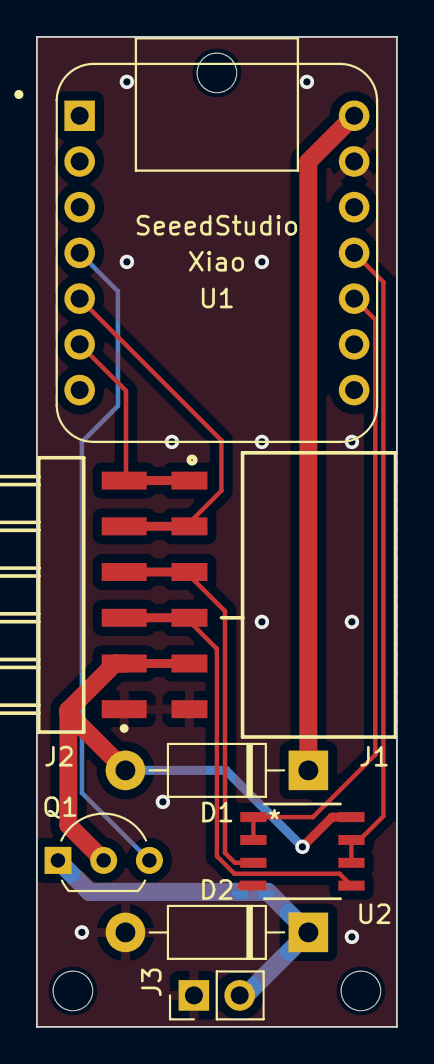
[picture p78: board Pneumatactors_1Xiao_ValveControl.kicad_pcb from above]

Board: 2 copper layers, 20.0 x 55.0 mm, 11 parts (0 on the bottom side), 11 nets.
