anwaypimpalkar/pneumatactors/Arduino Code/Xiao_BLE_Receive/Xiao_BLE_Receive.ino

#include <BLEDevice.h>
#include <BLEUtils.h>
#include <BLEServer.h>

// Define your custom service and characteristic UUIDs
#define SERVICE_UUID        "4fafc201-1fb5-459e-8fcc-c5c9c331914b"
#define CHARACTERISTIC_UUID "beb5483e-36e1-4688-b7f5-ea07361b26a8"

// Custom callback class to handle writes from phone
class MyCallbacks : public BLECharacteristicCallbacks {
    void onWrite(BLECharacteristic *pCharacteristic) {
      std::string value = pCharacteristic->getValue();

      if (value.length() > 0) {
        Serial.print("Received Value: ");
        for (int i = 0; i < value.length(); i++) {
          Serial.print(value[i]);
        }
        Serial.println();
      }
    }
};

void setup() {
  Serial.begin(115200);
  Serial.println("Starting BLE work!");

  // Initialize BLE device with a custom name
  BLEDevice::init("XIAO_ESP32S3");

  // Create BLE server and service
  BLEServer *pServer = BLEDevice::createServer();
  BLEService *pService = pServer->createService(SERVICE_UUID);

  // Create BLE characteristic with READ and WRITE properties
  BLECharacteristic *pCharacteristic = pService->createCharacteristic(
    CHARACTERISTIC_UUID,
    BLECharacteristic::PROPERTY_READ |
    BLECharacteristic::PROPERTY_WRITE
  );

  // Set initial value and write callback
  pCharacteristic->setValue("Hello World");
  pCharacteristic->setCallbacks(new MyCallbacks());

  // Start the service
  pService->start();

  // Start advertising
  BLEAdvertising *pAdvertising = BLEDevice::getAdvertising();
  pAdvertising->addServiceUUID(SERVICE_UUID);
  pAdvertising->setScanResponse(true);
  pAdvertising->setMinPreferred(0x06);  // helps with iPhone compatibility
  pAdvertising->setMinPreferred(0x12);
  BLEDevice::startAdvertising();

  Serial.println("BLE server is running. Connect and write from your phone.");
}

void loop() {
  // Nothing needed here for now
  delay(2000);
}
