anwaypimpalkar/pneumatactors/(commit log)

2025-03-06 initial file dump
    [Finger_SingleChamber_v1.stl, Finger_SingleChamber_v2_15.2.stl, Finger_SingleChamber_v2_15.6.stl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]
2025-03-12 updated virtual task
    [mapping_config.csv]
2025-03-14 2025-03-14 12:05:54
    [Pneumatactor_HAND_v1.stl, Pneumatactor_HAND_v2.stl, Pneumatactor_HAND_v3_15.6.stl]
2025-03-18 integrated emg!!
    [emg_data.csv]
2025-03-19 emg integrated!!
    [emg_data.csv, map_1.csv, map_2.csv, map_3.csv, p01_calibration.csv, p01_calibration_raw.csv, task_config.csv]
2025-03-19 PCB works!!
2025-03-20 emg better
    [p02_calibration.csv, p02_calibration_raw.csv, task_config.csv]
2025-03-23 2025-03-23 18:00:03
    [Compact_Control-B_Cu.gbr, Compact_Control-B_Mask.gbr, Compact_Control-B_Paste.gbr, Compact_Control-B_Silkscreen.gbr, Compact_Control-Edge_Cuts.gbr, Compact_Control-F_Cu.gbr, Compact_Control-F_Mask.gbr, Compact_Control-F_Paste.gbr]
2025-03-23 PCBs fixed
    [Compact_Control-B_Cu.gbr, Compact_Control-B_Mask.gbr, Compact_Control-B_Paste.gbr, Compact_Control-B_Silkscreen.gbr, Compact_Control-Edge_Cuts.gbr, Compact_Control-F_Cu.gbr, Compact_Control-F_Mask.gbr, Compact_Control-F_Paste.gbr]
2025-03-24 2025-03-24 00:00:04
    [Pneumatactors_1Xiao_CompactControl.kicad_pcb, Pneumatactors_1Xiao_CompactControl.kicad_sch]
2025-03-27 2025-03-27 00:00:06
    [Current vs Resistor.xlsx, Pneumatactors_1Xiao_CompactControl.kicad_pcb, Pneumatactors_1Xiao_CompactControl.step, Solenoid Holder with tubing.SLDPRT, Solenoid Holder with tubing.STL, TLC_Valve_Current_Calculations.xlsx]
2025-03-29 characterization 1 curve
    [000_Baseline0.csv, 000_Baseline200.csv, 005_200.csv, 010_050.csv, 010_200.csv, 015_200.csv, 020_050.csv, 020_060.csv]
2025-06-20 2025-03-29 18:00:06
    [000_000.csv, 000_200.csv, 005_200.csv, 005_200_C001H001S0001_displacement.csv, 005_200_C001H001S0001_pressure.csv, 010_050.csv, 010_070.csv, 010_200.csv]
2025-06-25 app update
    [U00_Trial01_20250624_202822.csv, U00_Trial01_20250624_203244.csv, U00_Trial01_20250624_204553.csv, U00_Trial01_20250624_214750.csv, U00_Trial01_20250624_215702.csv, U00_Trial01_20250624_215923.csv, U00_Trial01_20250624_221855.csv, U00_Trial01_20250624_223251.csv]
2025-06-25 Create 60Hz White Noise 1HR.mp3
2025-07-01 U18 :))
    [U18_Trial01_20250630_193317.csv, U18_Trial02_20250630_193436.csv, U18_Trial03_20250630_193659.csv, U18_Trial05_20250630_194629.csv, U18_Trial06_20250630_194850.csv, U18_Trial08_20250630_195854.csv, U18_Trial09_20250630_200116.csv, U18_Trial12_20250630_201315.csv]
