anwaypimpalkar/pneumatactors/(notices)

Notices in the files:
PCBs/Pneumatactors_1Xiao_ValveControl/Pneumatactors_1Xiao_ValveControl.kicad_pcb:
© A. Pimpalkar, HAMR Lab 2024
PCBs/Pneumatactors_4Xiao_ValveControl/Pneumatactors_4Xiao_ValveControl.kicad_pcb:
© Anway Pimpalkar 2025
PCBs/Pneumatactors_1Xiao_2PiezoPumps_2Valves/Pneumatactors_1Xiao_PiezoPumps_2Valves.kicad_pcb:
© A. Pimpalkar
PCBs/Pneumatactors_1Xiao_3Pumps_8Valves/Pneumatactors_1Xiao_3Pumps_8Valves.kicad_pcb:
© Anway Pimpalkar, HAMR Lab
